gitzzc/GLHW/VacuumGauge/微信图片_20200117162444.jpg

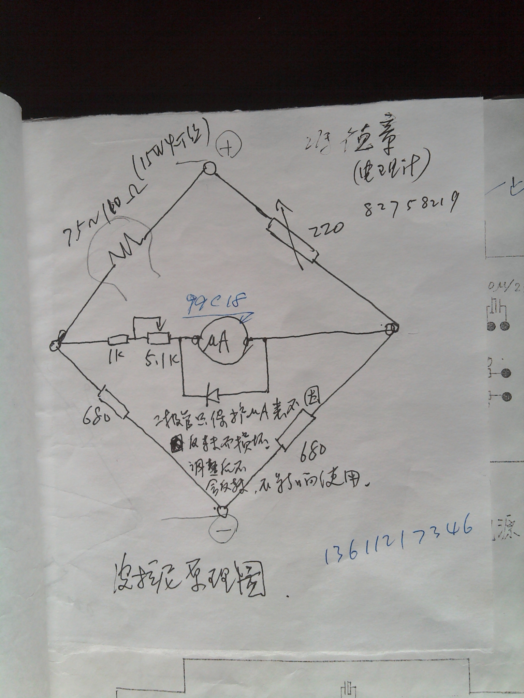
VacuumGauge/微信图片_20200117162444.jpg
