gitzzc/GLHW/AL1000/Ver1.10/更改说明.txt

20200602 
问题：		RS485无法接收数据
原因：		ADUM输入信号需要进行上拉处理，
处理方式：	临时短路二极管，改板时在ADUM输入信号进行上拉。
