gitzzc/GLHW/AL1000/Ver1.10/AL1000装配资料/AL1000-1.xlsx

Comment | Description | Designator | Footprint | LibRef | Quantity
100nF | 贴片电容 | C1, C2, C3, C4, C5, C7, C8, C9, C14, C15, C18, C20, C22, C23, C26, C28, C31, C34, C36_1, C36_2, C36_3, C38_1, C38_2, C38_3, C39_1, C39_2, C39_3, C42_1, C42_2, C42_3, C45_1, C45_2, C45_3, C46_1, C46_2, C46_3, C47_1, C47_2, C47_3, C48_1, C48_2, C48_3, C49_1, C49_2, C49_3, C50_1, C50_2, C50_3, C51_1, C51_2, C51_3, C52_1, C52_2, C52_3, C53_1, C53_2, C53_3, C54_1, C54_2, C54_3, C55_1, C55_2, C55_3, C56_1, C56_2, C56_3, C57, C59, C60, C61, C62, C63, C64, C65, C66, C67, C68, C69, C70, C71, C72, C73, C74, C75, C77, C78, C80, C82, C83, C84, C85, C86, C87, C88, C90, C92, C93, C94, C95, C96, C97, C99, C100, C102, C103, C104, C105 | 0805_C | 0805 100nF(104) 10% 50V | 107
10uF | Capacitor, 贴片电容 | C6, C12, C13, C17, C19, C21, C25, C27, C33, C37_1, C37_2, C37_3, C41_1, C41_2, C41_3, C76, C79, C89, C101 | 0805_C | 0805 10uF (106) 10% 25V, 1206 10uF (106) 10% 50V, CC | 19
100pF/2KV | Capacitor | C10, C81, C91, C98 | 1206_C | Cap | 4
47uF/50V | Electrolytic Capacitor | C11 | CD1/2 | CD1 | 1
10uF/50V | 贴片电容 | C16, C24 | 1206_C | 1206 10uF (106) 10% 50V | 2
10pF | Capacitor | C29, C30 | 0805_C | CAP | 2
10nF | 多层瓷介电容 | C32 | 0805_C | G-CC41-0805-CG-50V-300J | 1
1nF | Capacitor | C35_1, C35_2, C35_3, C40_1, C40_2, C40_3, C43_1, C43_2, C43_3, C44_1, C44_2, C44_3 | 0805_C | CAP | 12
100uF/50V | Polarized Capacitor (Radial) | C58 | CD1.5/3.2 | Cap Pol1 | 1
SS54 |  | D1 | SMA(DO-214AC)_S1 | SMA(DO-214AC) SS54 | 1
1.5SMC33CA |  | D2, D31 | SMC(DO-214AB)_S1 | TVS | 2
SMA6J5CA | 1V5KE6V8CA | D3, D22, D23, D24 | SMA | Bidirectional DIODE TVS, TVS | 4
STM32F107VCT |  | D4 | LQFP-100_14x14x05P | BARRACUDA_256K | 1
1N4148W | Default Diode | D5, D6, D26, D28 | SOD-123 | Diode | 4
M7 |  | D7_1, D7_2, D7_3 | SMA(DO-214AC)_S1 | SMA(DO-214AC) M7 | 3
SMAJ18A | 1V5KE6V8CA | D8_1, D8_2, D8_3, D9_1, D9_2, D9_3, D10_1, D10_2, D10_3, D15, D16, D17, D18, D19, D20, D21 | SMA | Bidirectional DIODE TVS, TVS | 16
红灯 0805 |  | D11_1, D11_2, D11_3, D13_1, D13_2, D13_3, D25, D27 | 0805_LED_S1 | 0805 红灯 | 8
SMF12 | Zener Diode | D12_1, D12_2, D12_3, D14_1, D14_2, D14_3 | SOD-123 | D Zener | 6
GZ2012D101TF |  | L1, L2, L3, L4, L5_1, L5_2, L5_3, L6_1, L6_2, L6_3, L8_1, L8_2, L8_3, L9_1, L9_2, L9_3, L11, L12, L13, L14, L15, L16, L17 | 0805_L | L1 | 23
NT90RN1C |  | LS1, LS2 | NT90HCE12CE | NT90RN1C | 2
Header 9 | Header, 9-Pin | M1, M2, M3, M4, M5, M6 | LK | Header 9 | 6
24V | Header, 2-Pin | P1, P9 | mc1.5/2-st-3.81 | Header 2 | 2
Header 6 | Header, 6-Pin | P2 | TJC3-6A | Header 6 | 1
ESP-07S | Header, 8-Pin, Dual row | P3 | ESP-07S | Header 8X2 | 1
Header 8 | Header, 8-Pin | P4_1, P4_2, P4_3, P8 | MC1.5/8-ST-3.81 | Header 8 | 4
 | Header, 4-Pin, Right Angle | P5 | MSTBV 2.5/4-G-5.08 | Header 4H | 1
Header 5 | Header, 5-Pin | P6, P7 | MC1.5/5-ST-3.81 | Header 5 | 2
Header 15X2 | Header, 15-Pin, Dual row | P10 | HDR2X15 | Header 15X2 | 1
HY911105AE |  | P11 | HANRUN-A8 | J0011D21B | 1
BAT | Header, 2-Pin | P12 | TJC3-2A | Header 2 | 1
DB9/F |  | P13 | DB9P/F | DB9 | 1
MMBT5401 2L |  | Q1_1, Q1_2, Q1_3, Q2_1, Q2_2, Q2_3, Q8_1, Q8_2, Q8_3, Q9, Q11 | SOT-23(SOT-23-3) | SOT-23 MMBT5401 2L | 11
2N7002 | MOS(场效应管) | Q3_1, Q3_2, Q3_3, Q5_1, Q5_2, Q5_3 | SOT-23(SOT-23-3) | 2N7002 7002 | 6
IRLR024N | HEXFET Power MOSFET | Q4_1, Q4_2, Q4_3 | TO-252AA_N | IRLR024N | 3
IRFR5305 | HEXFET Power MOSFET | Q7_1, Q7_2, Q7_3 | TO-252AA_N | IRFR5305 | 3
2K2 | Resistor | R1, R2, R17, R18, R19, R20, R21, R87 | 0805_R | Res1 | 8
1K5 | Resistor | R3, R4 | 0805_R | Res1 | 2
49.9 | Resistor | R5, R6, R7, R8 | 0805_R | Res1 | 4
220 | Resistor | R9, R10 | 0805_R | Res1 | 2
33 | Resistor | R11, R12, R13, R14, R15, R16, R22, R90, R92, R96, R97, R101, R102 | 0805_R | Res1 | 13
4.87K | Resistor | R23 | 0805_R | Res1 | 1
1M | Resistor | R24, R93, R98, R103 | 1206_R | Res1 | 4
1K | Resistor, 贴片电阻 | R25, R31, R45_1, R45_2, R45_3, R50_1, R50_2, R50_3, R52_1, R52_2, R52_3, R55, R56_1, R56_2, R56_3, R105 | 0805_R | 0805 100KΩ (1003) 1%, res1, RMK2012KBxxx（10～1M）F | 16
100K | Resistor, 贴片电阻 | R26, R27, R35_1, R35_2, R35_3, R40_1, R40_2, R40_3, R46_1, R46_2, R46_3, R47_1, R47_2, R47_3, R54_1, R54_2, R54_3, R57_1, R57_2, R57_3, R58_1, R58_2, R58_3, R61_1, R61_2, R61_3 | 0805_R | 0805 100KΩ (1003) 1%, Res1, Res2 | 26
10K | Resistor, 贴片电阻 | R28, R30, R32, R38_1, R38_2, R38_3, R43_1, R43_2, R43_3, R64_1, R64_2, R64_3, R65_1, R65_2, R65_3, R70, R71, R72, R73, R86, R107 | 0805_R | Res1, Res2, RMK2012KBxxx（10～1M）F | 21
NI | 贴片电阻 | R29 | 0805_R | RMK2012KBxxx（10～1M）F | 1
330 | Resistor, 贴片电阻 | R33_1, R33_2, R33_3, R34_1, R34_2, R34_3, R39_1, R39_2, R39_3, R44_1, R44_2, R44_3, R67_1, R67_2, R67_3 | 0805_R | 0805 100Ω (1000) 1%, Res2 | 15
200K | Resistor | R36_1, R36_2, R36_3, R41_1, R41_2, R41_3 | 0805_R | Res2 | 6
100 | Resistor, 贴片电阻 | R37_1, R37_2, R37_3, R42_1, R42_2, R42_3, R49_1, R49_2, R49_3, R88, R89, R91, R94, R95, R99, R100 | 0805_R | 0805 100KΩ (1003) 1%, Res1, Res2 | 16
5.1KΩ | 贴片电阻 | R48_1, R48_2, R48_3, R59_1, R59_2, R59_3 | 0805_R | 0805 5.1KΩ (5101) 1% | 6
22K | 贴片电阻 | R51_1, R51_2, R51_3 | R0805 | RMK2012KBxxx（10～1M）F | 3
10KΩ | 贴片电阻 | R53_1, R53_2, R53_3, R60_1, R60_2, R60_3 | 0805_R | 0805 10KΩ (1002) 1% | 6
33R | Resistor | R62_1, R62_2, R62_3 | R2512 | Res2 | 3
0.33 | Resistor | R63_1, R63_2, R63_3, R82, R83, R84, R85 | R2512 | Res1, Res2 | 7
22K | 贴片电阻 | R66_1, R66_2, R66_3 | 0805_R | RMK2012KBxxx（10～1M）F | 3
510 | Resistor | R68, R69 | 0805_R | Res1 | 2
20K | Resistor | R104, R108 | 0805_R | Res1 | 2
120 | Resistor | R106 | 0805_R | Res1 | 1
ACM9070-701-2PL-TL01 | TDP ACP3225 Common Mode Filters | T1 | ACM1211 | ACP3225 | 1
DP83848CVVX | 接口芯片 | U1 | LQFP-48_7x7x05P | DP83848CVVX_[C16688] | 1
VRB2405YMD-6WR3 |  | U2 | DC/DC-1X1 | 48S5 | 1
LD1117AG-33 | 3-Terminal Adjustable Positive Voltage Regulator | U3 | SOT-223 | LM1117 | 1
HT7550-1 | 低压差线性稳压(LDO) | U4 | SOT-89(SOT-89-3) | SOT-89 HT7550-1 | 1
LM4040AIM3-2.5 | Precision Micropower Shunt Voltage Reference, 3-pin SOT-23 | U5, U12_1, U12_2, U12_3 | MF03A_N | LM4040AIM3-2.5 | 4
FM25W256 |  | U6 | SO8 | SPI_FLASH | 1
SG-310SCF 25MHZ 3.3V |  | U7 | SMD-3225_4P | SM7745HEV-50.0M | 1
HCNR201 |  | U8_1, U8_2, U8_3, U11_1, U11_2, U11_3 | SMD-8_9.0mm | HCNR201 | 6
LM2904-SR | Dual Low-Power Operational Amplifier | U9_1, U9_2, U9_3, U10_1, U10_2, U10_3, U14_1, U14_2, U14_3 | SOIC-8_150mil | LM2904D | 9
ADUM1200AR | Dual Channel Digital Isolator, 2.5 KV rms Insulation Rating, 1 Mbps Data Rate, 150 ns Delay, Industrial, 8-pin SOIC (R-8), Tube | U13_1, U13_2, U13_3, U20, U22, U24, U26 | ADI-R-8_N | ADUM1200AR | 7
EL817S1(C)(TU)-F |  | U15_1, U15_2, U15_3, U16, U17, U27, U38 | LC-SMD-4 | TLP521 | 7
A4950 |  | U19, U21, U23, U25 | LC-SOIC-8_EP_150mil | A4950 | 4
MAX232ESE | RS232 | U28, U31, U34 | SOIC-16_150mil | MAX232ESE_[C26860] | 3
B0505S-W2R2 | MORNSUN Fixed input,Isolated,Unregulated Series DC/DC | U29, U32, U35 | MORNSUN-BM | MORNSUN-BM | 3
ADUM1201ARZ-RL7 |  | U30, U33, U36 | SOIC-8_150mil | ADUM1201ARZ-RL7_[C9669] | 3
SP485EEN-L/TR | RS-485/RS-422 | U37 | SOIC-8_150mil | SP485EEN-L/TR_[C6855] | 1
32.768KHz ±20ppm 12.5pF | 贴片晶振 | Y1 | SMD-3215_2P FC - 135 | SMD-3215_2P 32.768KHz 20ppm 12.5pF | 1
