gitzzc/GLHW/(list of files, cad)

Other CAD files:
AL1000/Ver1.10/AL1000.DWG
