gitzzc/GLHW/AL1000/Ver1.10/AL1000.pdf

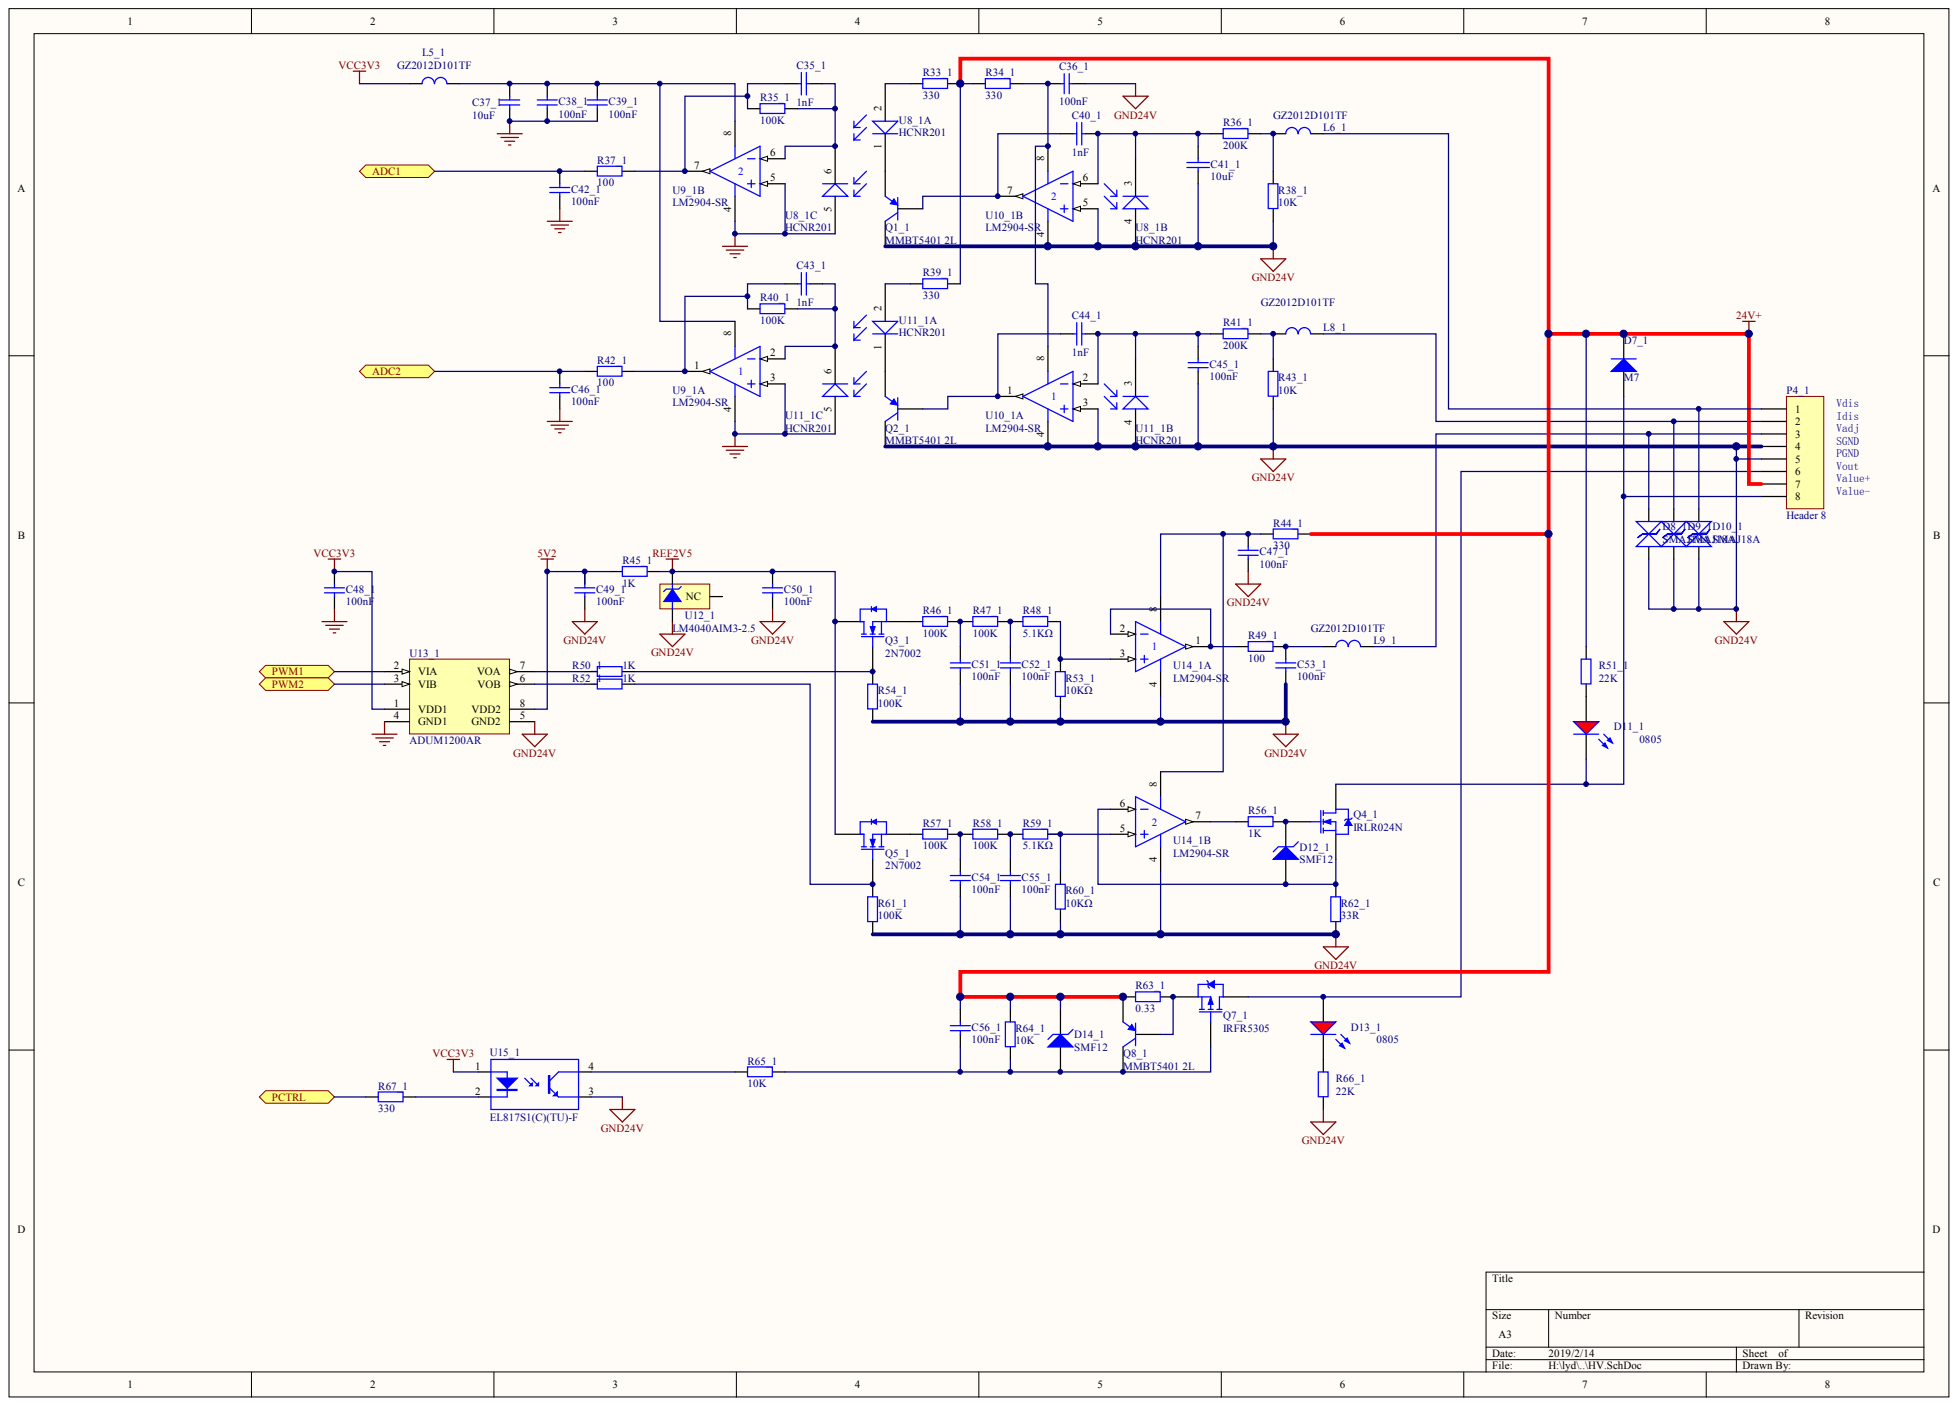
[picture p2: page 1]

GND24V

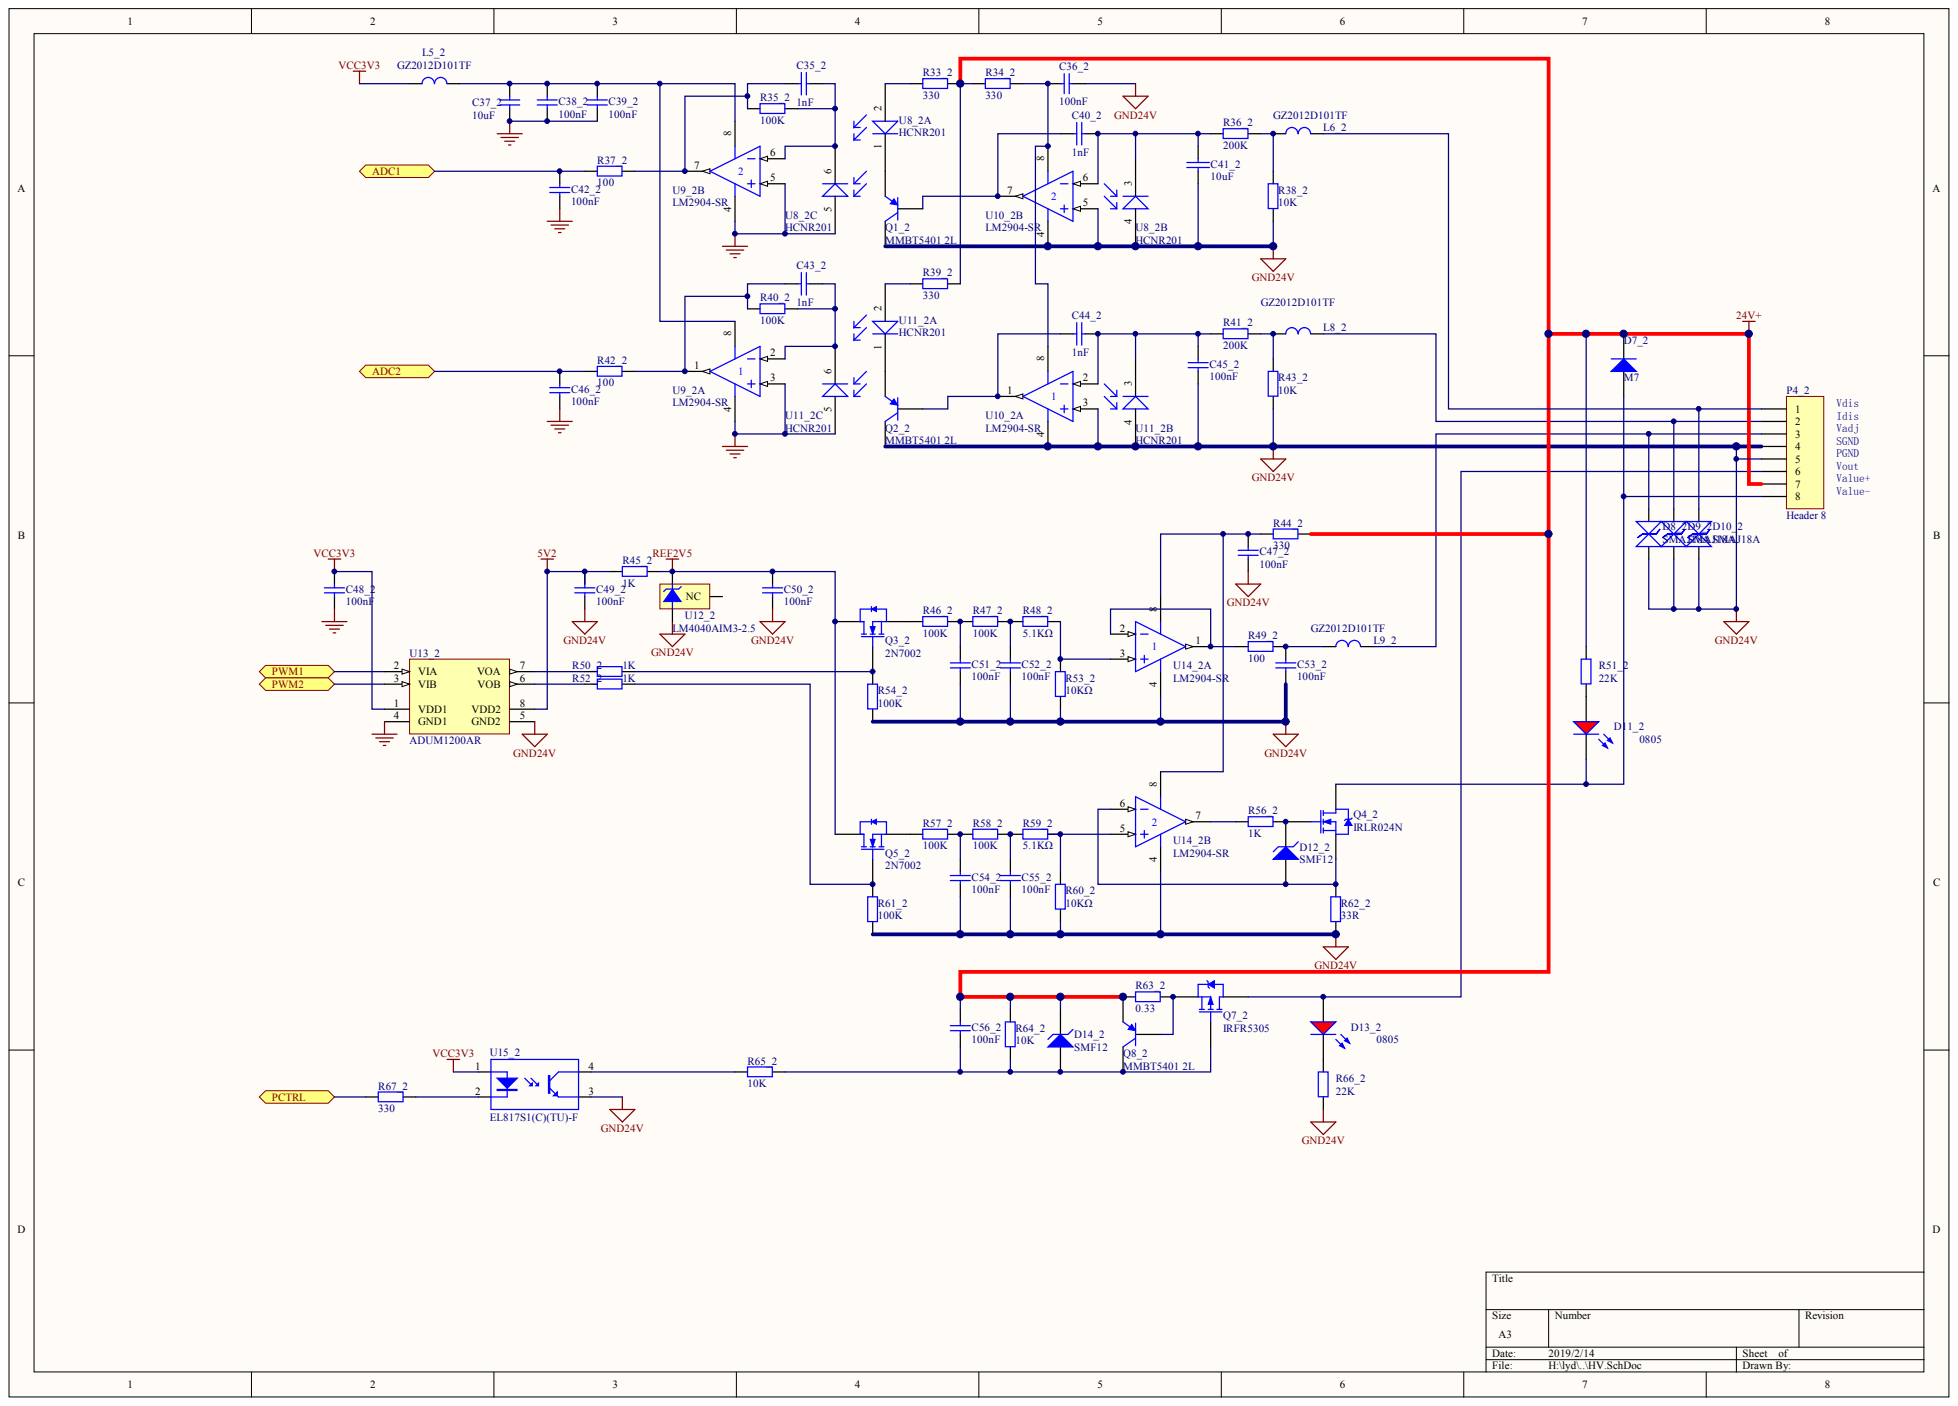
[picture p3: page 2]

GND24V

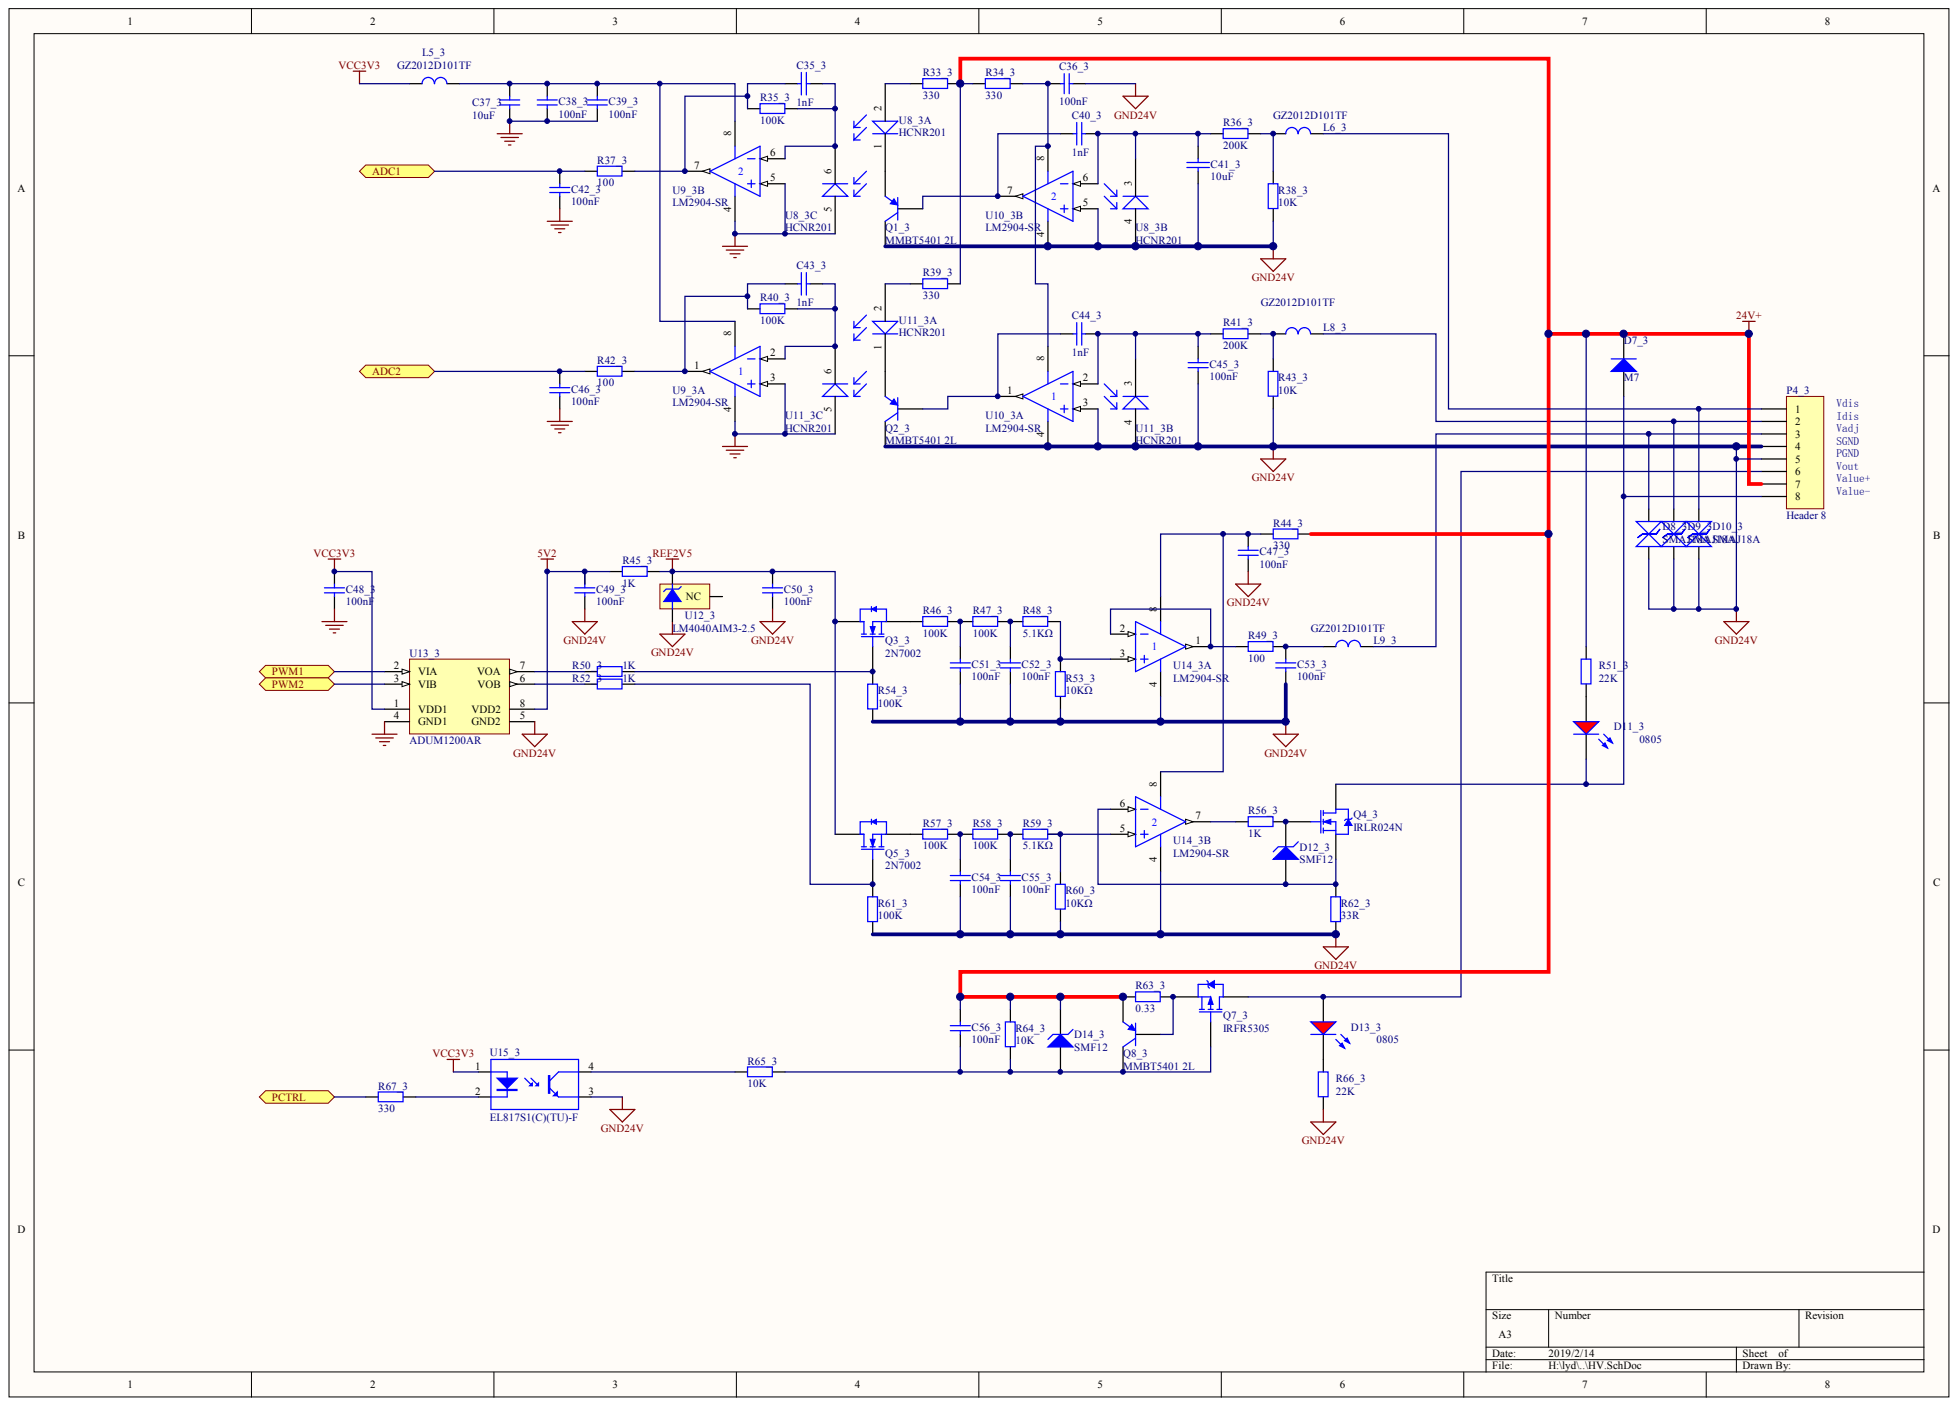
[picture p4: page 3]

GND24V

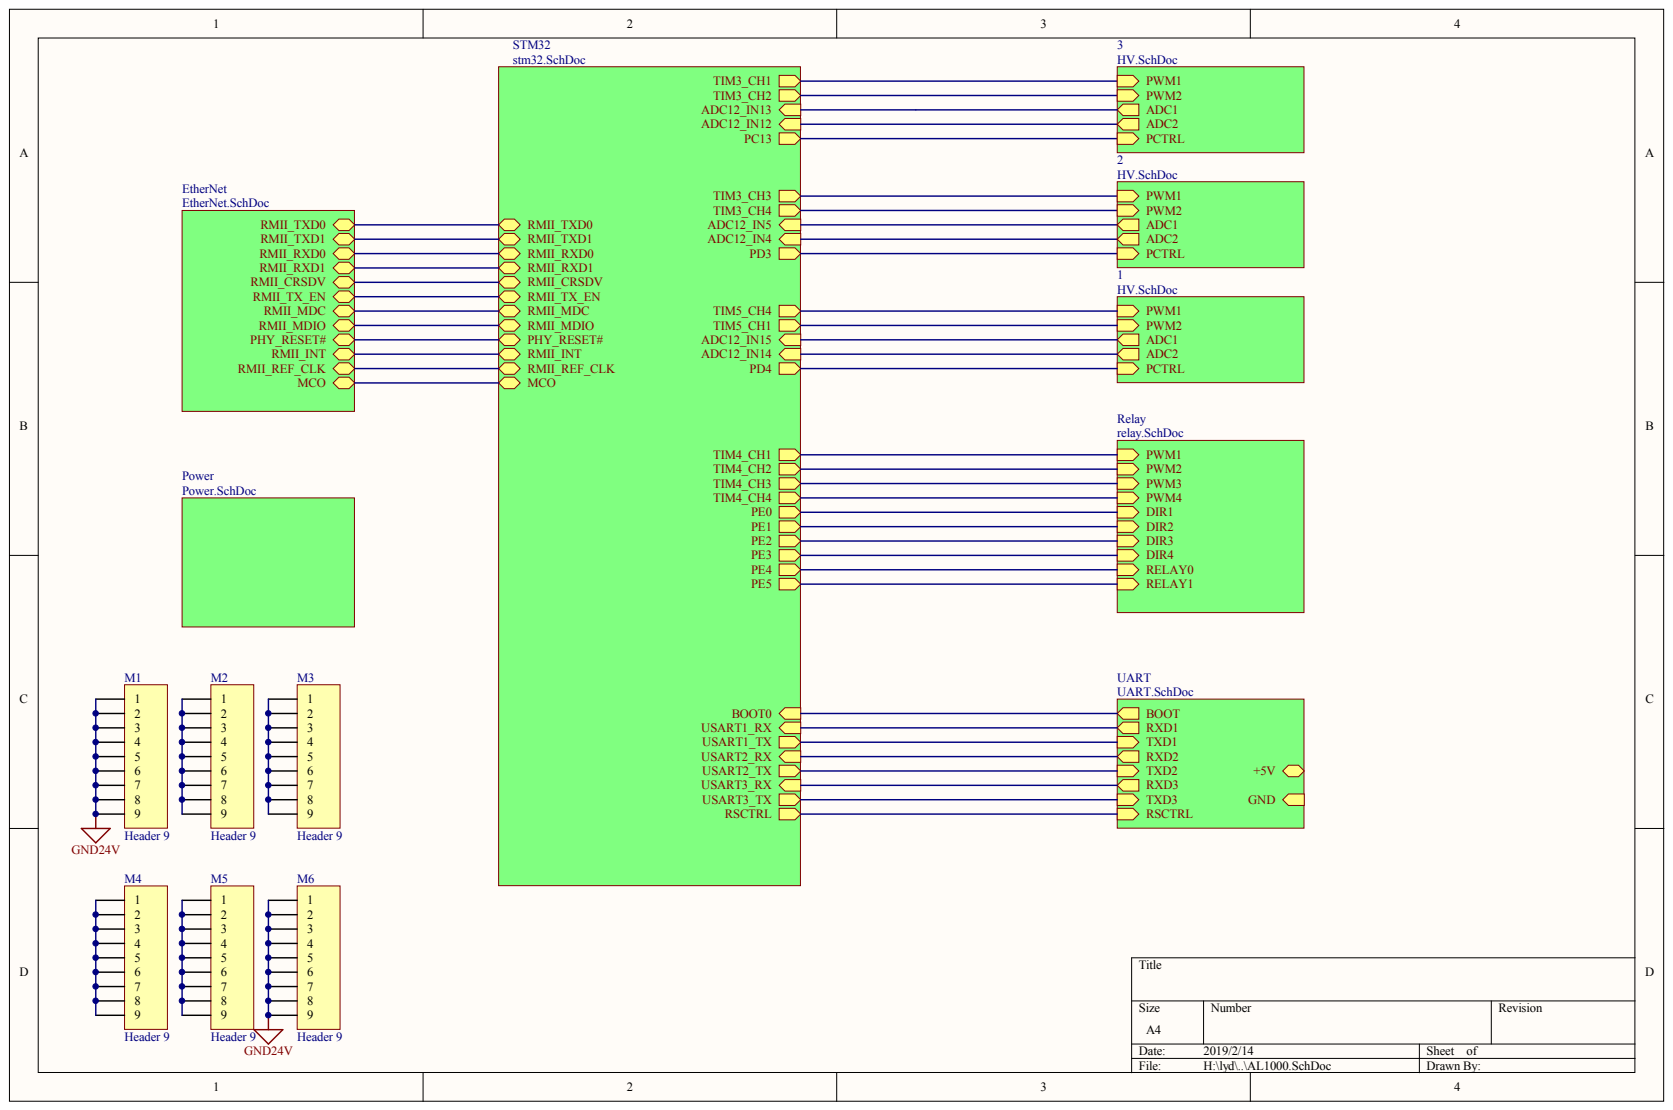
[picture p5: page 4]

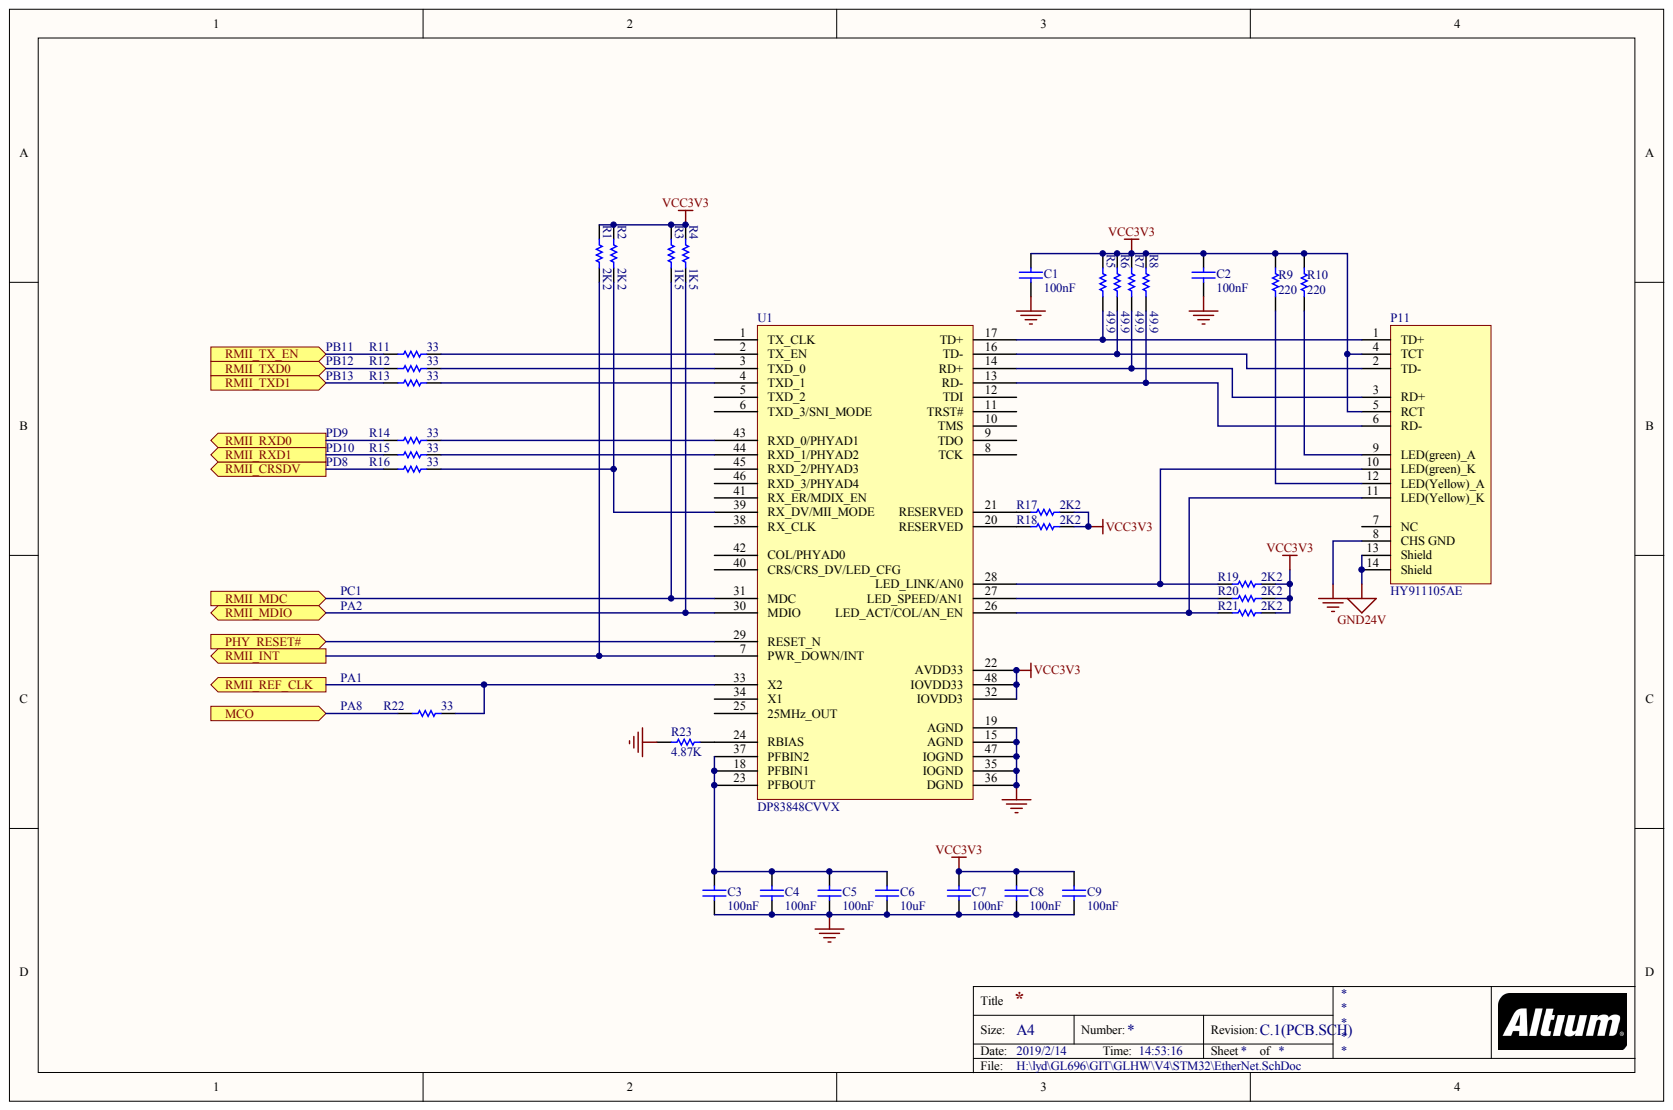
[picture p6: page 5]

TX_EN 2 | | TCT 4
TXD_0 3 | TD- 2
TXD_1 4 | | RD+ 3
TXD_2 5
TXD_3/SNI_MODE 6 | RCT 5

RXD_1/PHYAD2 44

LED(green)_A 9

COL/PHYAD0 42 | | CHS GND 8

Shield 13

Title * | * * * * *

Size: A4 | Number: * | Revision: C.1(PCB.SCH)
Date: 2019/2/14 Time: 14:53:16 | | Sheet * of *

H:\lyd\GL696\GIT\GLHW\V4\STM32\EtherNet.SchDoc

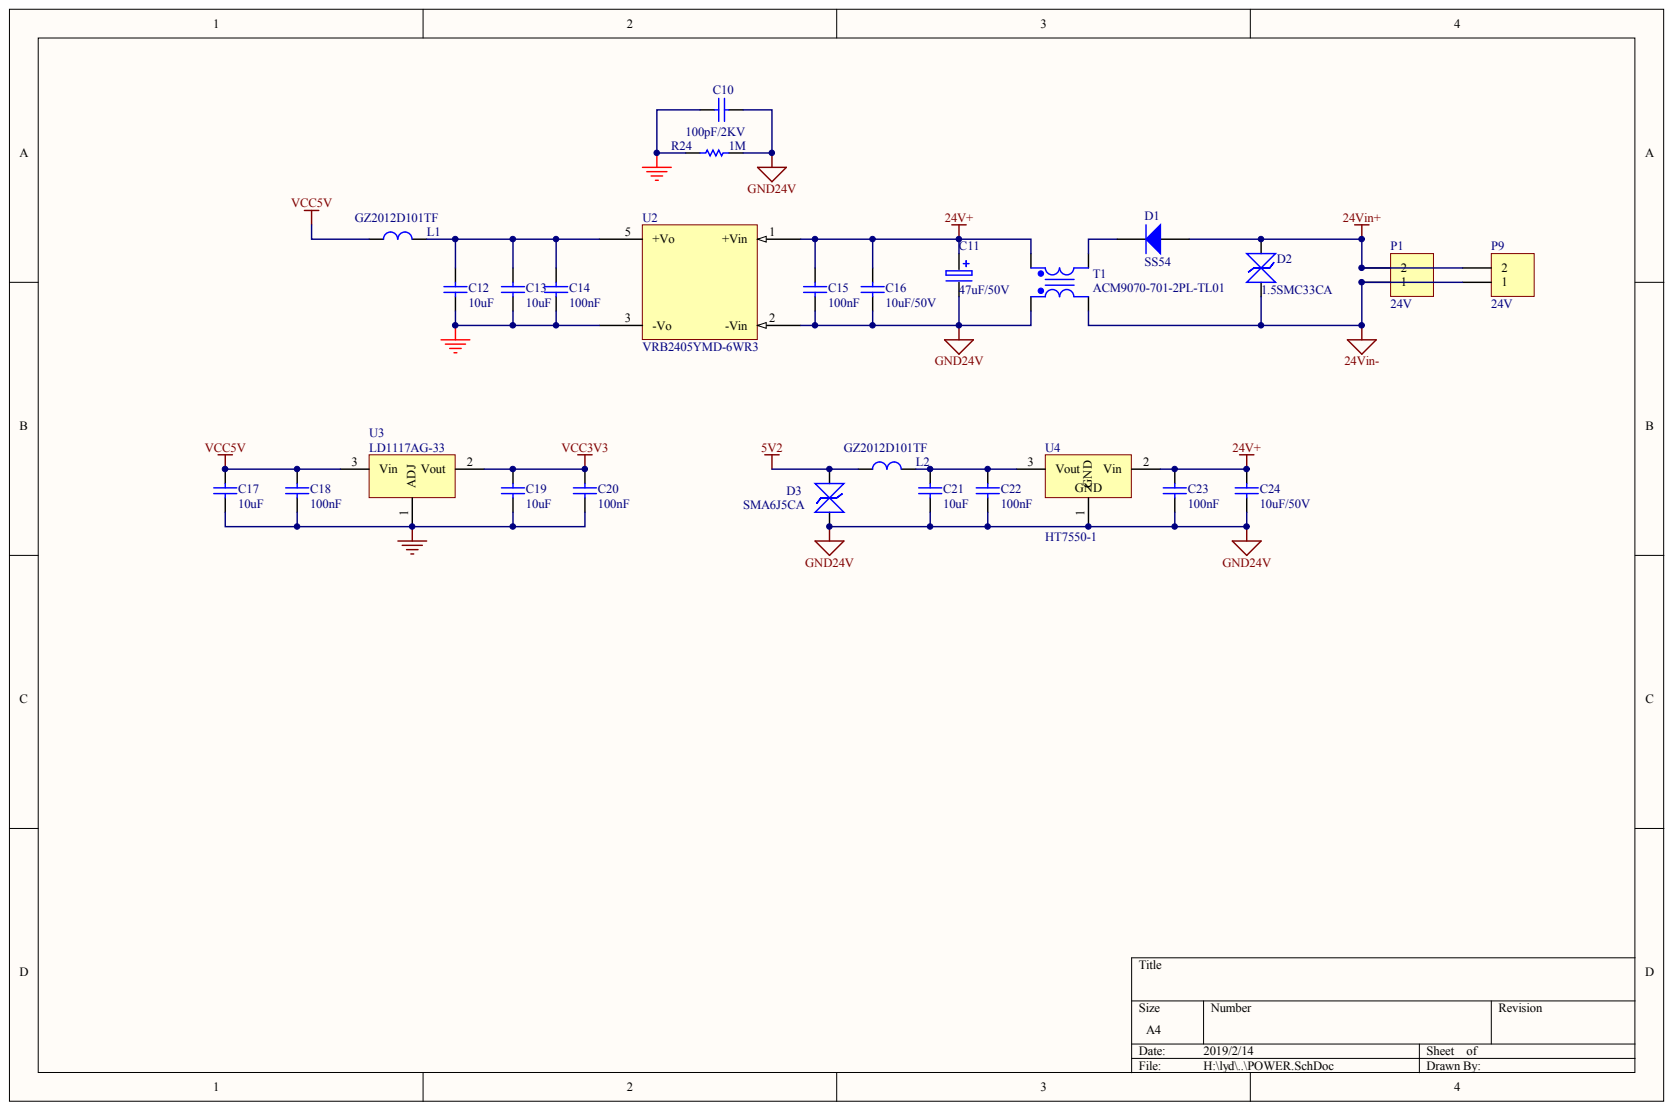
[picture p7: page 6]

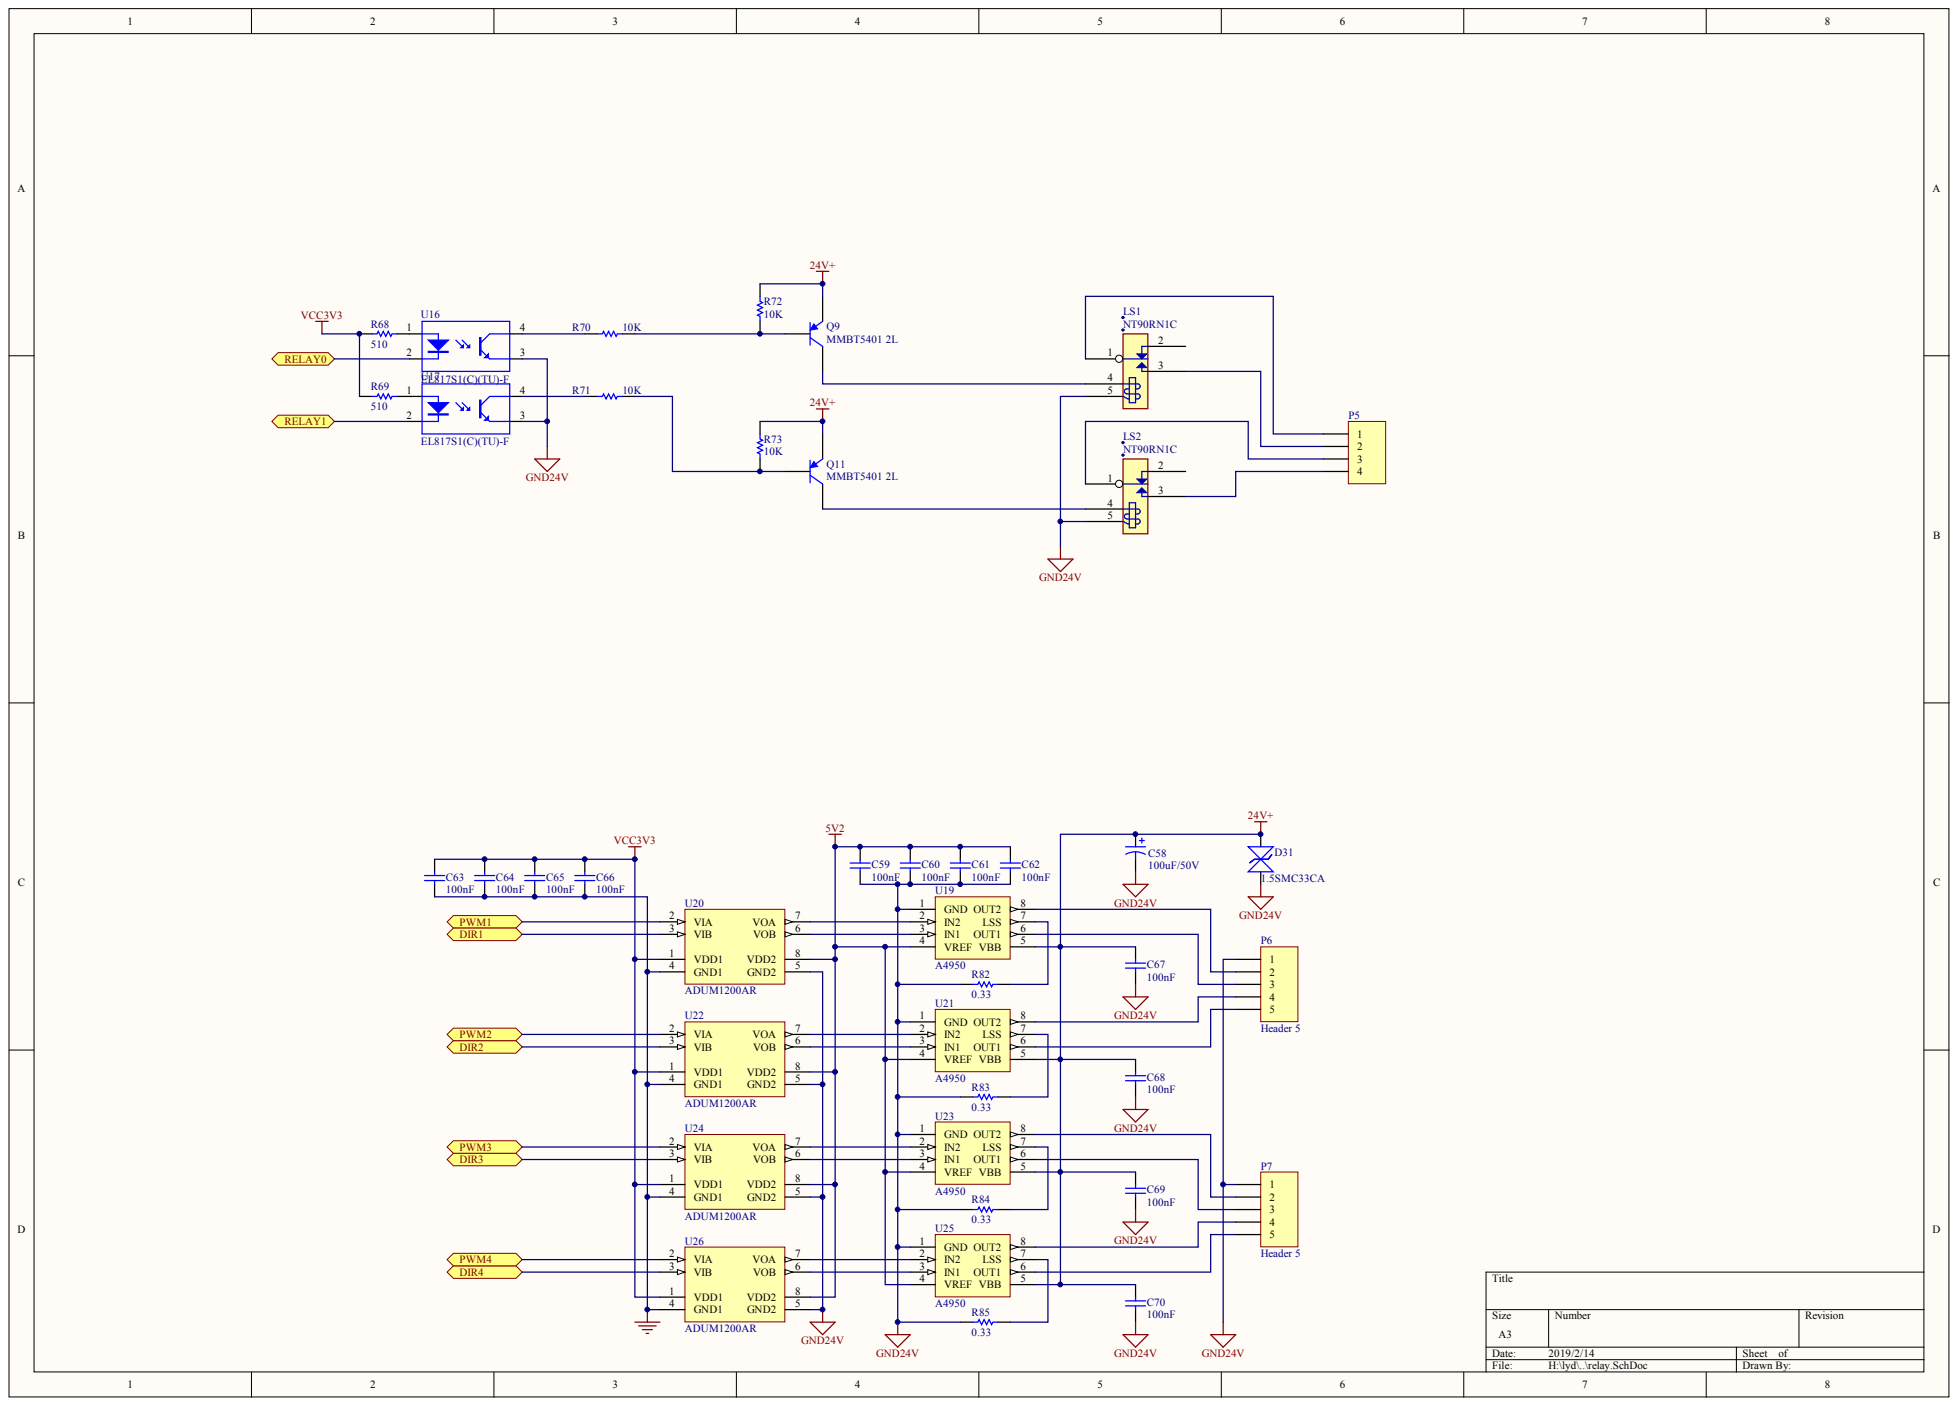
[picture p8: page 7]

GND 1

VIB 3
VDD1 1 | VREF 4

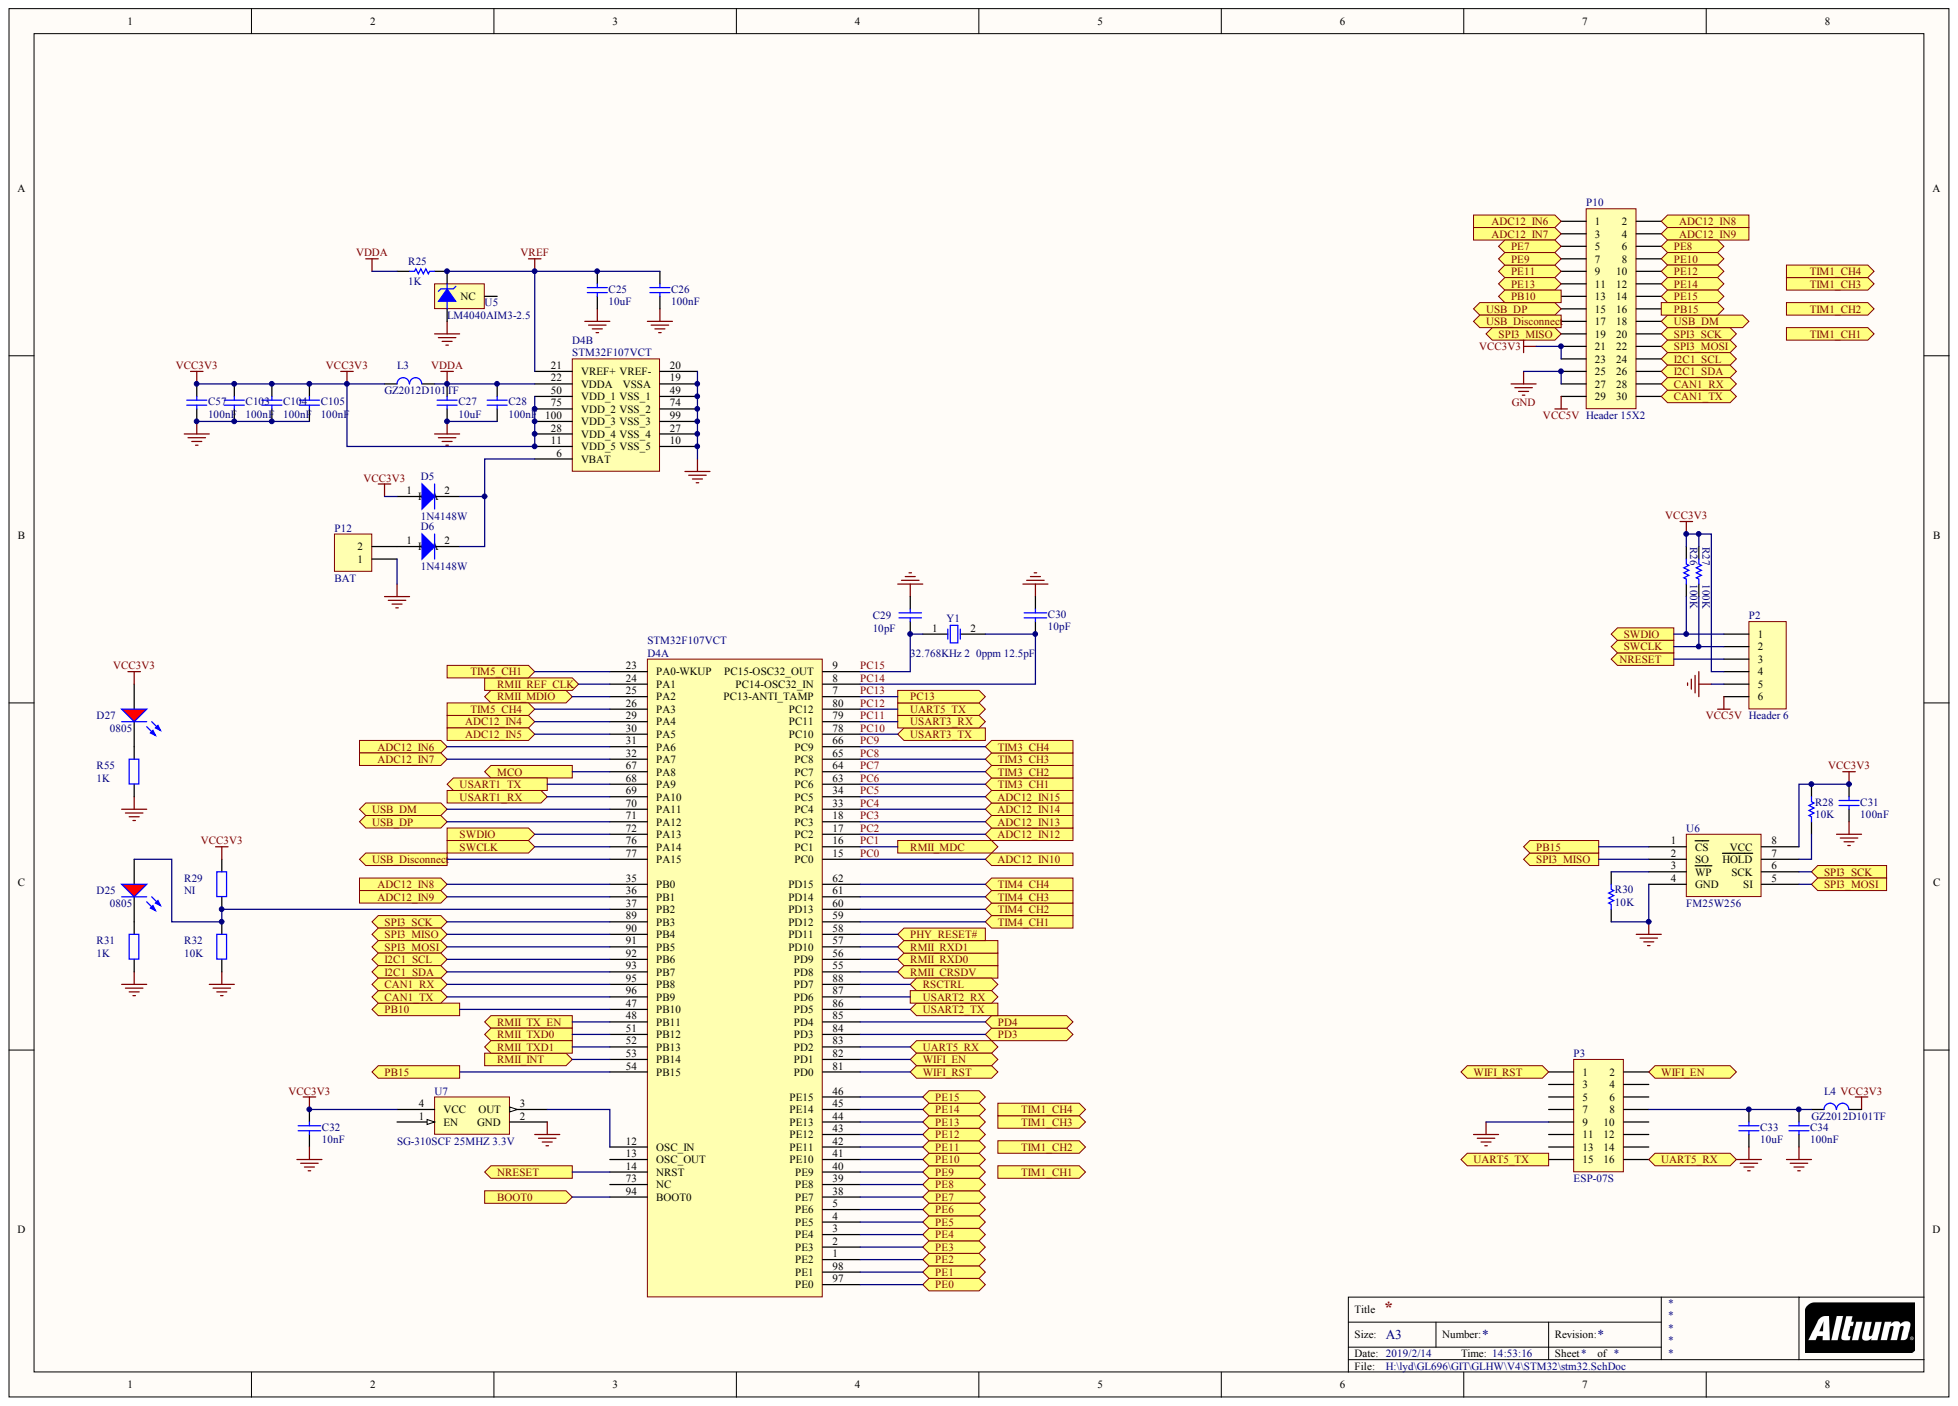
[picture p9: page 8]

2 8 | 2
1 1 | 1

A | mber: * | Revisio n : *

9/2/1 Time: 4:5 3:1 | | S heet * o f *

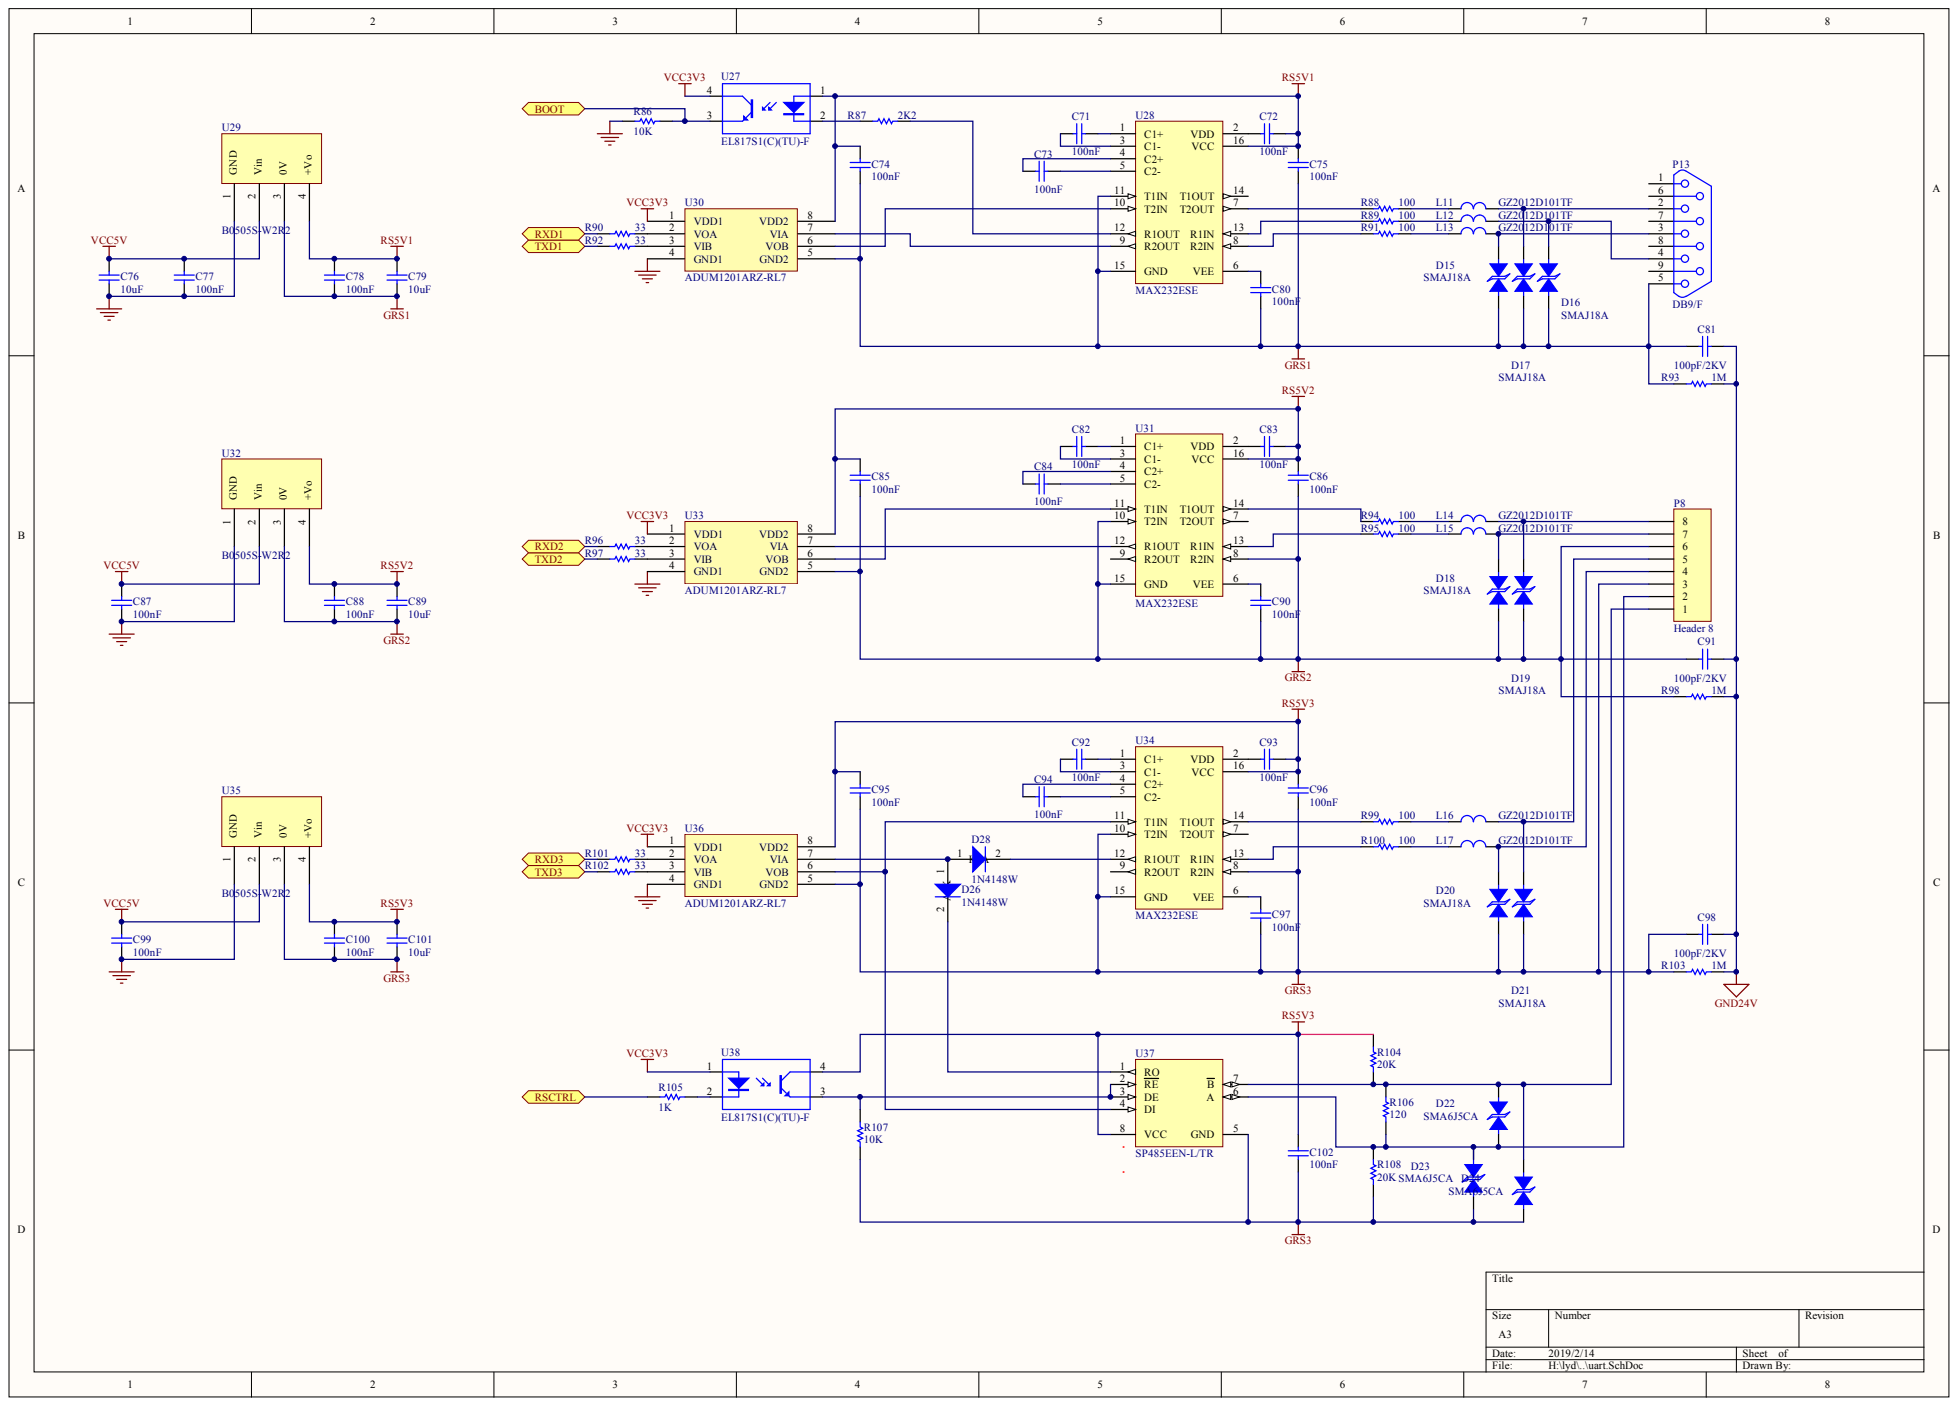
[picture p10: page 9]

C7 4 | C7 3 1 0 0 n F | 4 | C1 -VCC C2 + C2 -

3 D2 1 SMAJ1 8 A RS

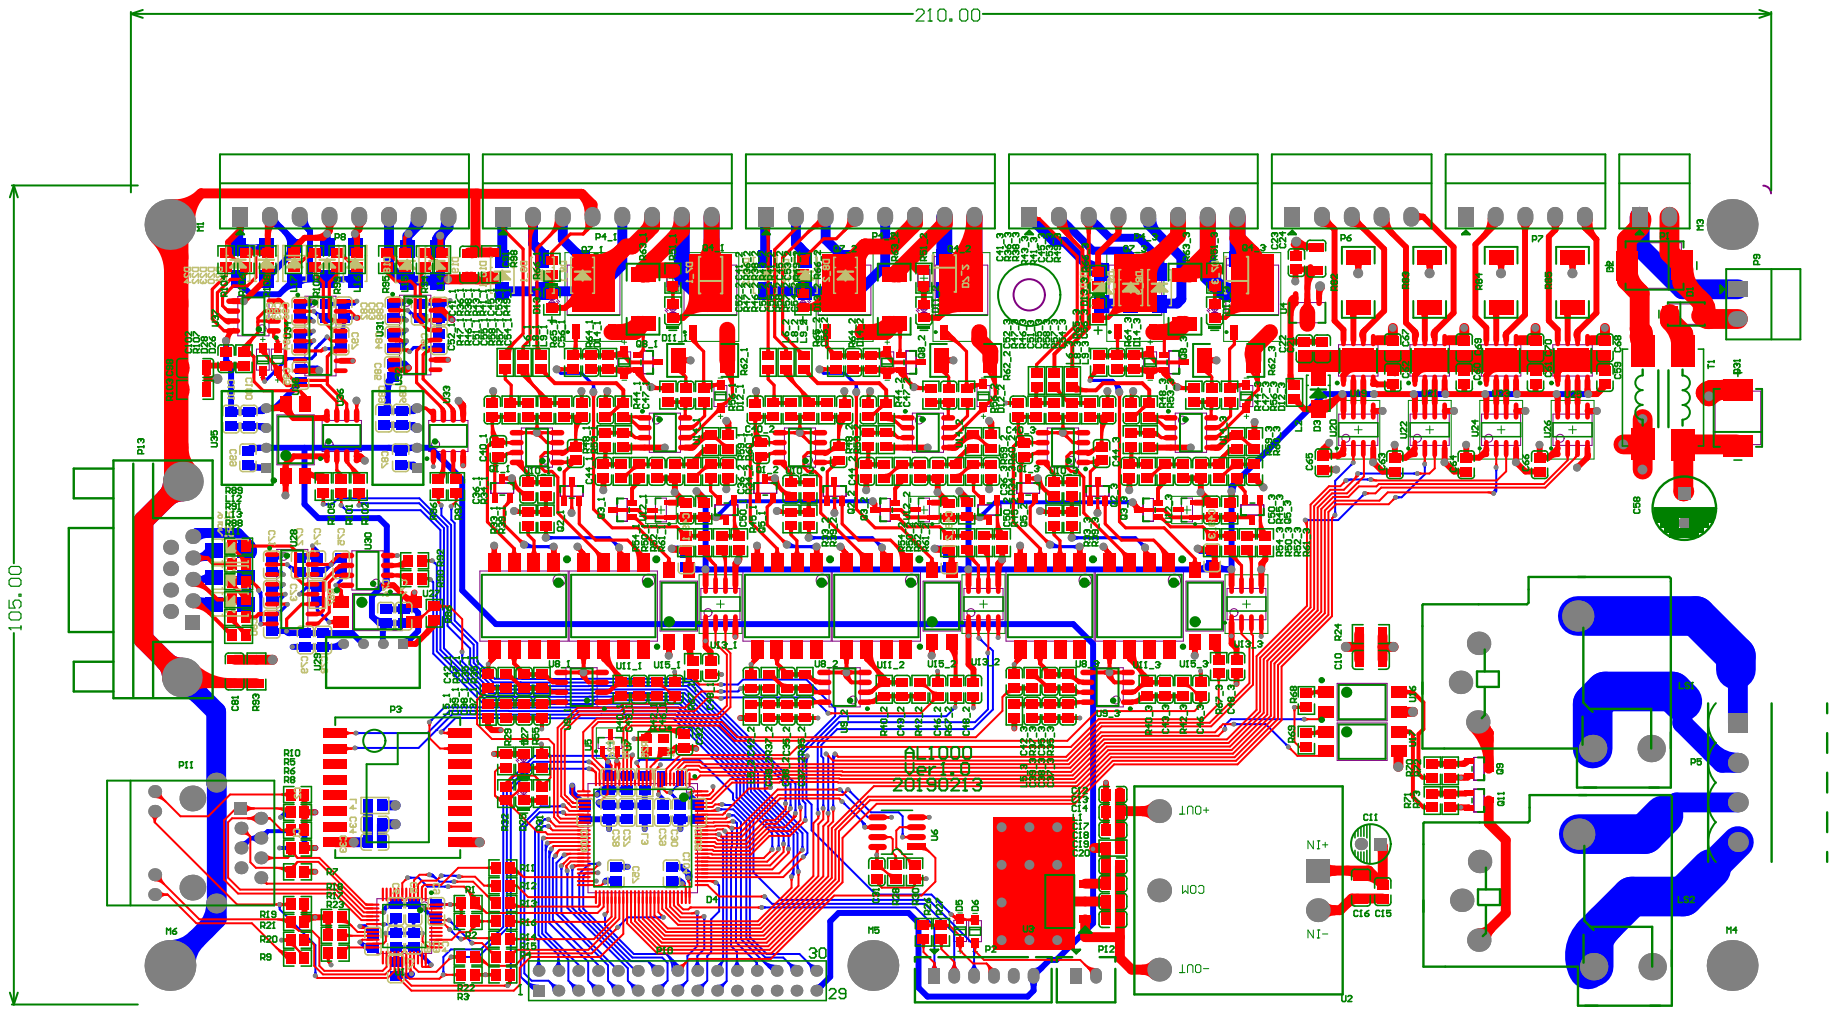
[picture p11: page 10]
