gitzzc/GLHW/AL1000/Ver1.10/AL1000装配图.pdf

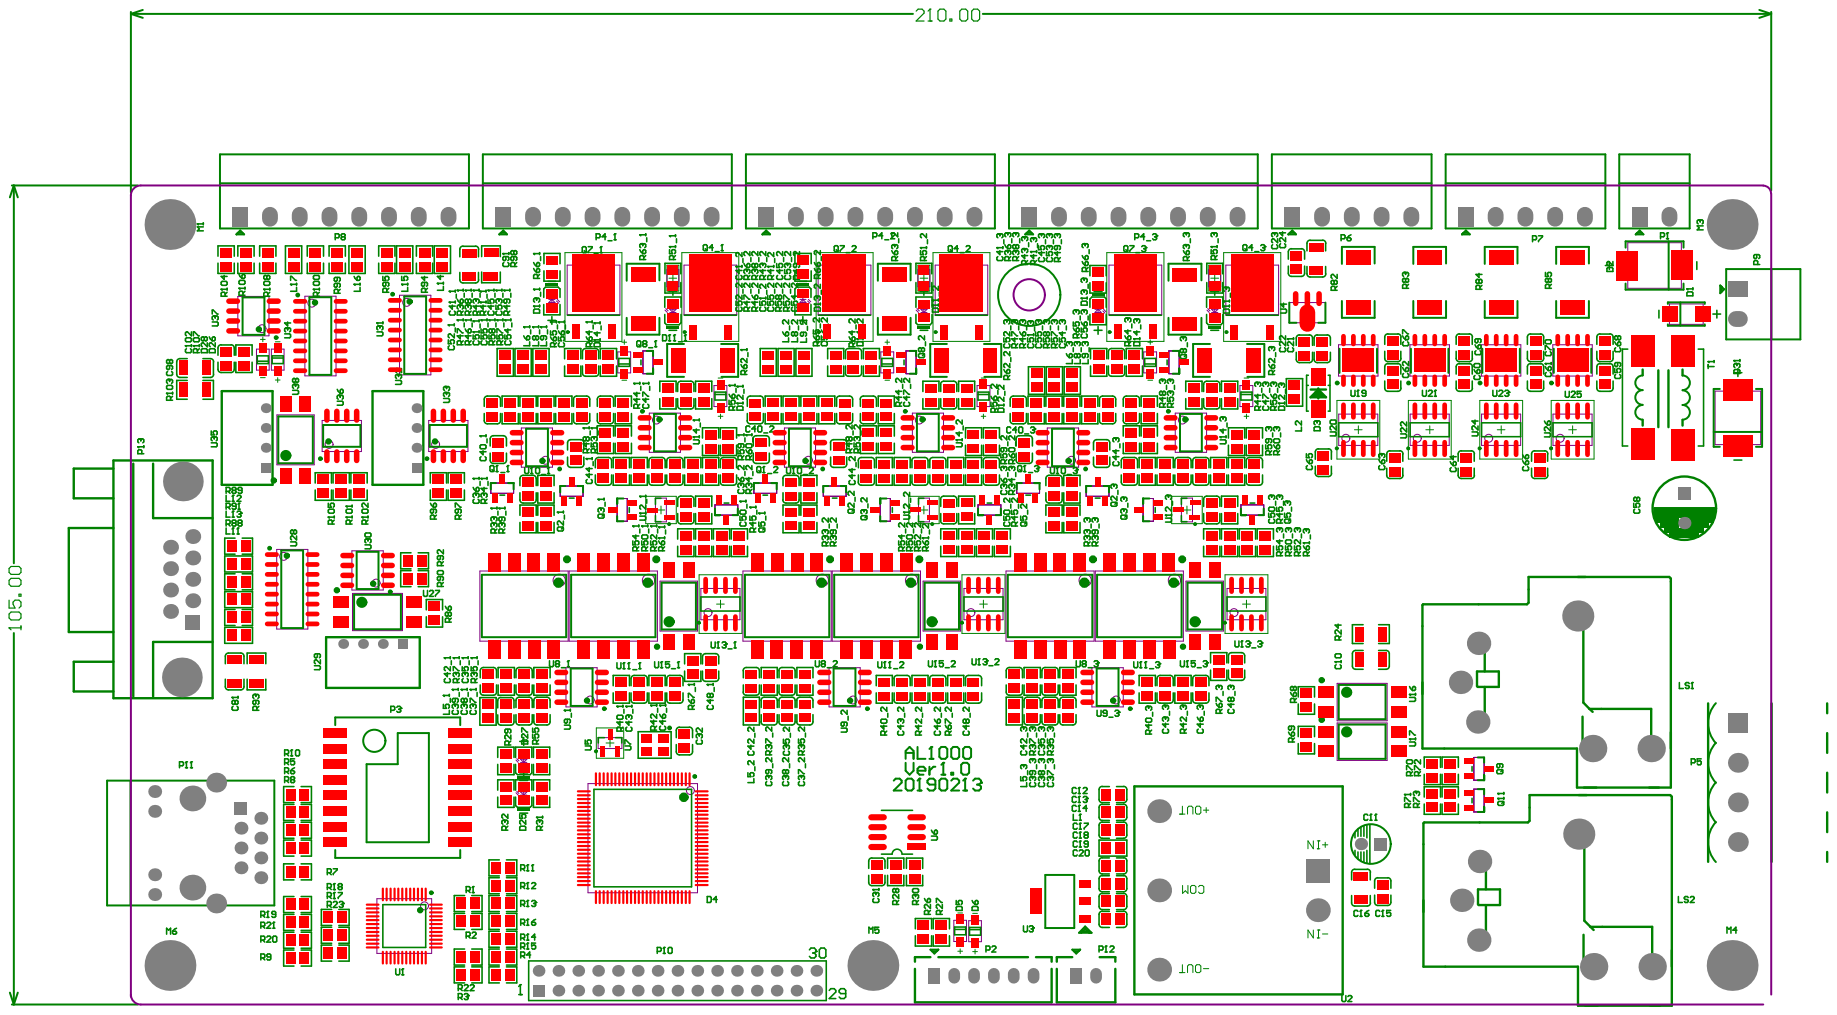
[picture p12: page 1]

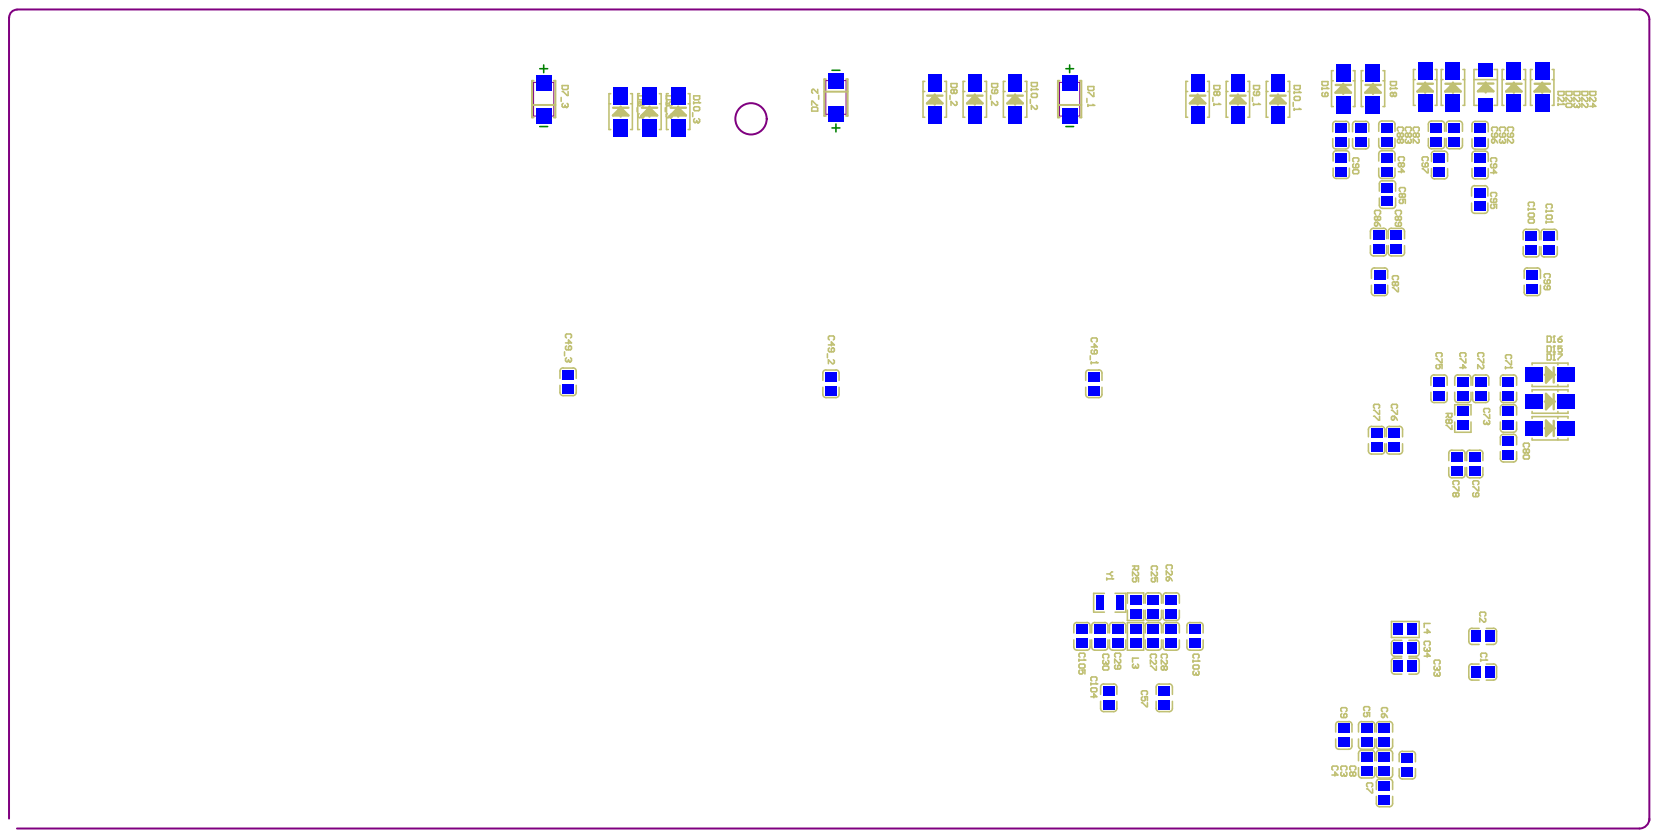
[picture p13: page 2]
