gitzzc/GLHW/AL1000/Ver1.10/AL1000装配图2.pdf

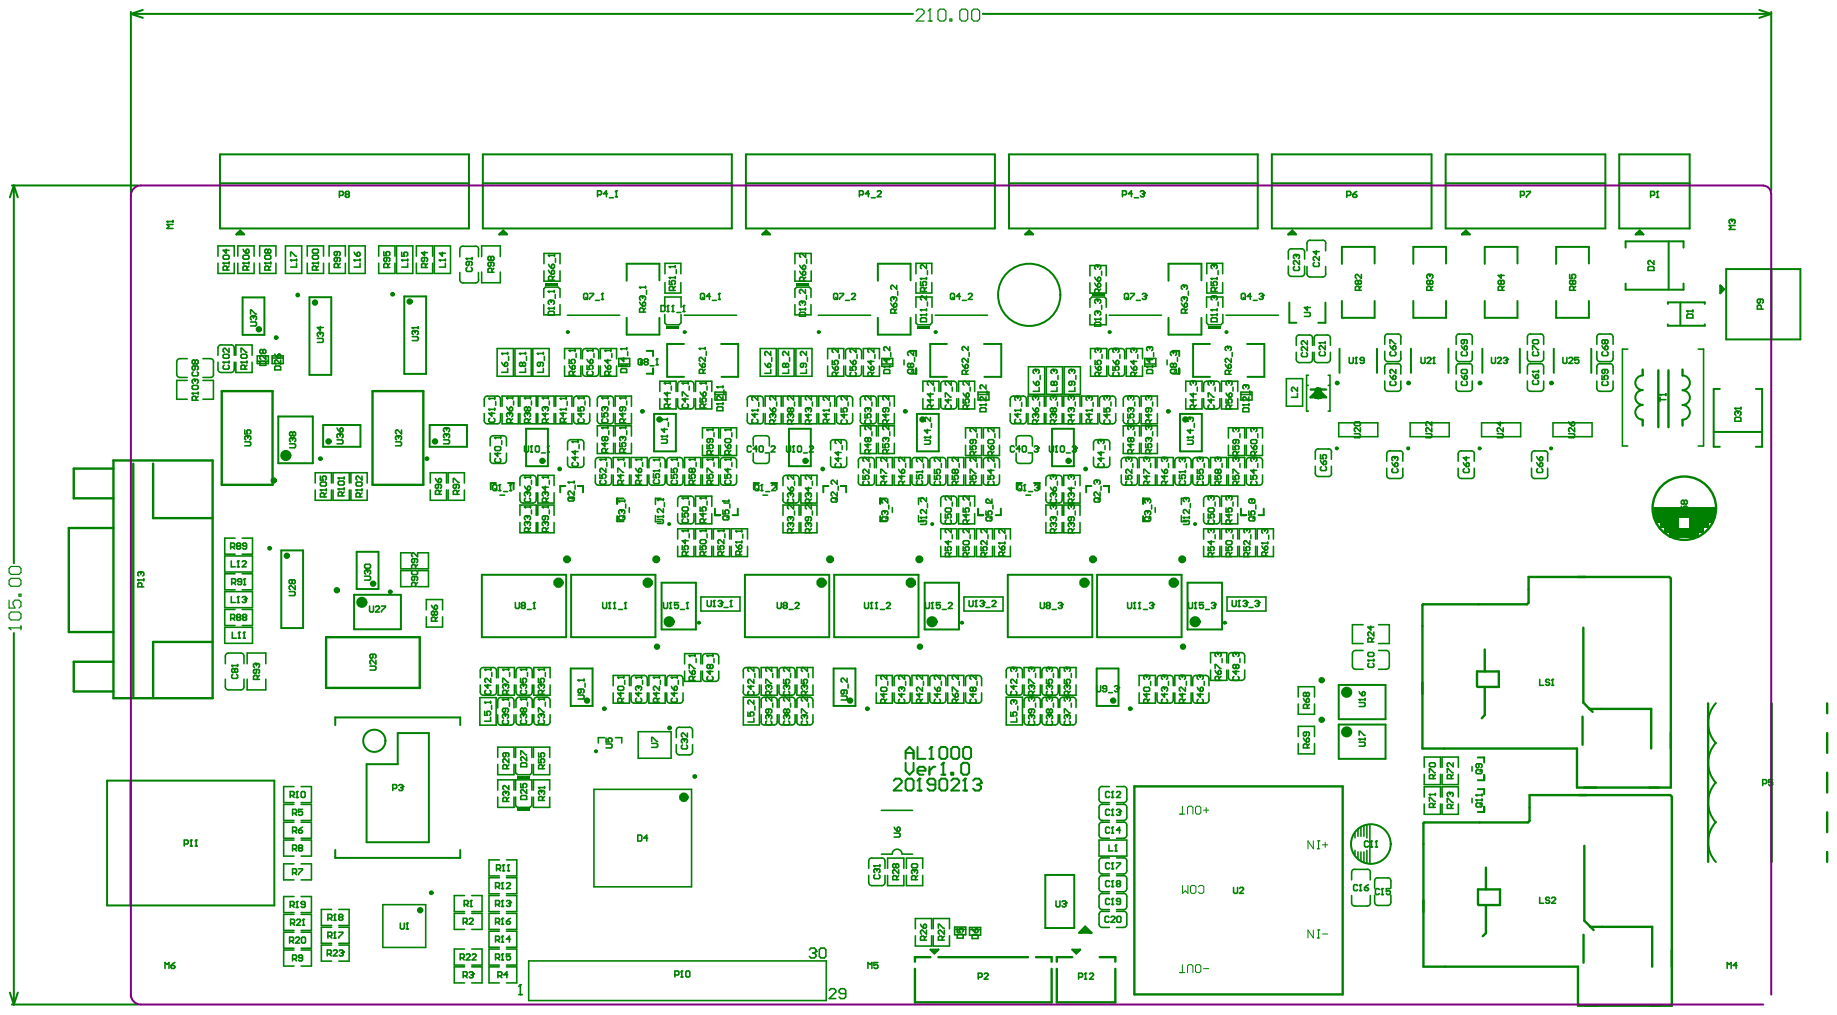
[picture p14: page 1]

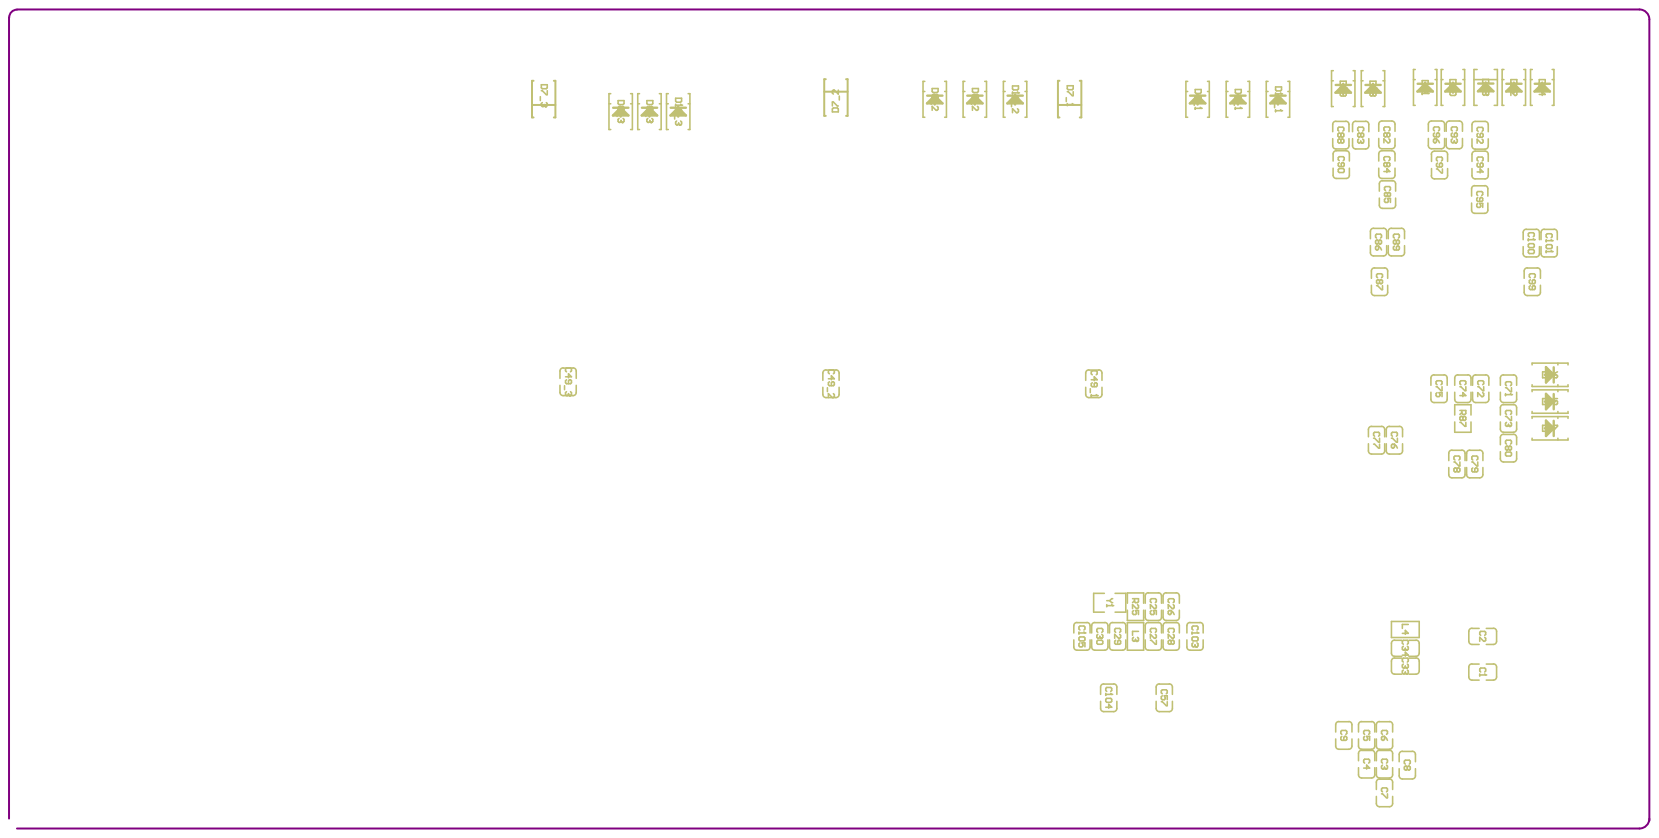
[picture p15: page 2]
