gitzzc/GLHW/AL1000/Ver1.10/接线、装配/Schematic_AL1000_系统接线图.SchDoc_20200329145429.pdf

P812345678

P8-7

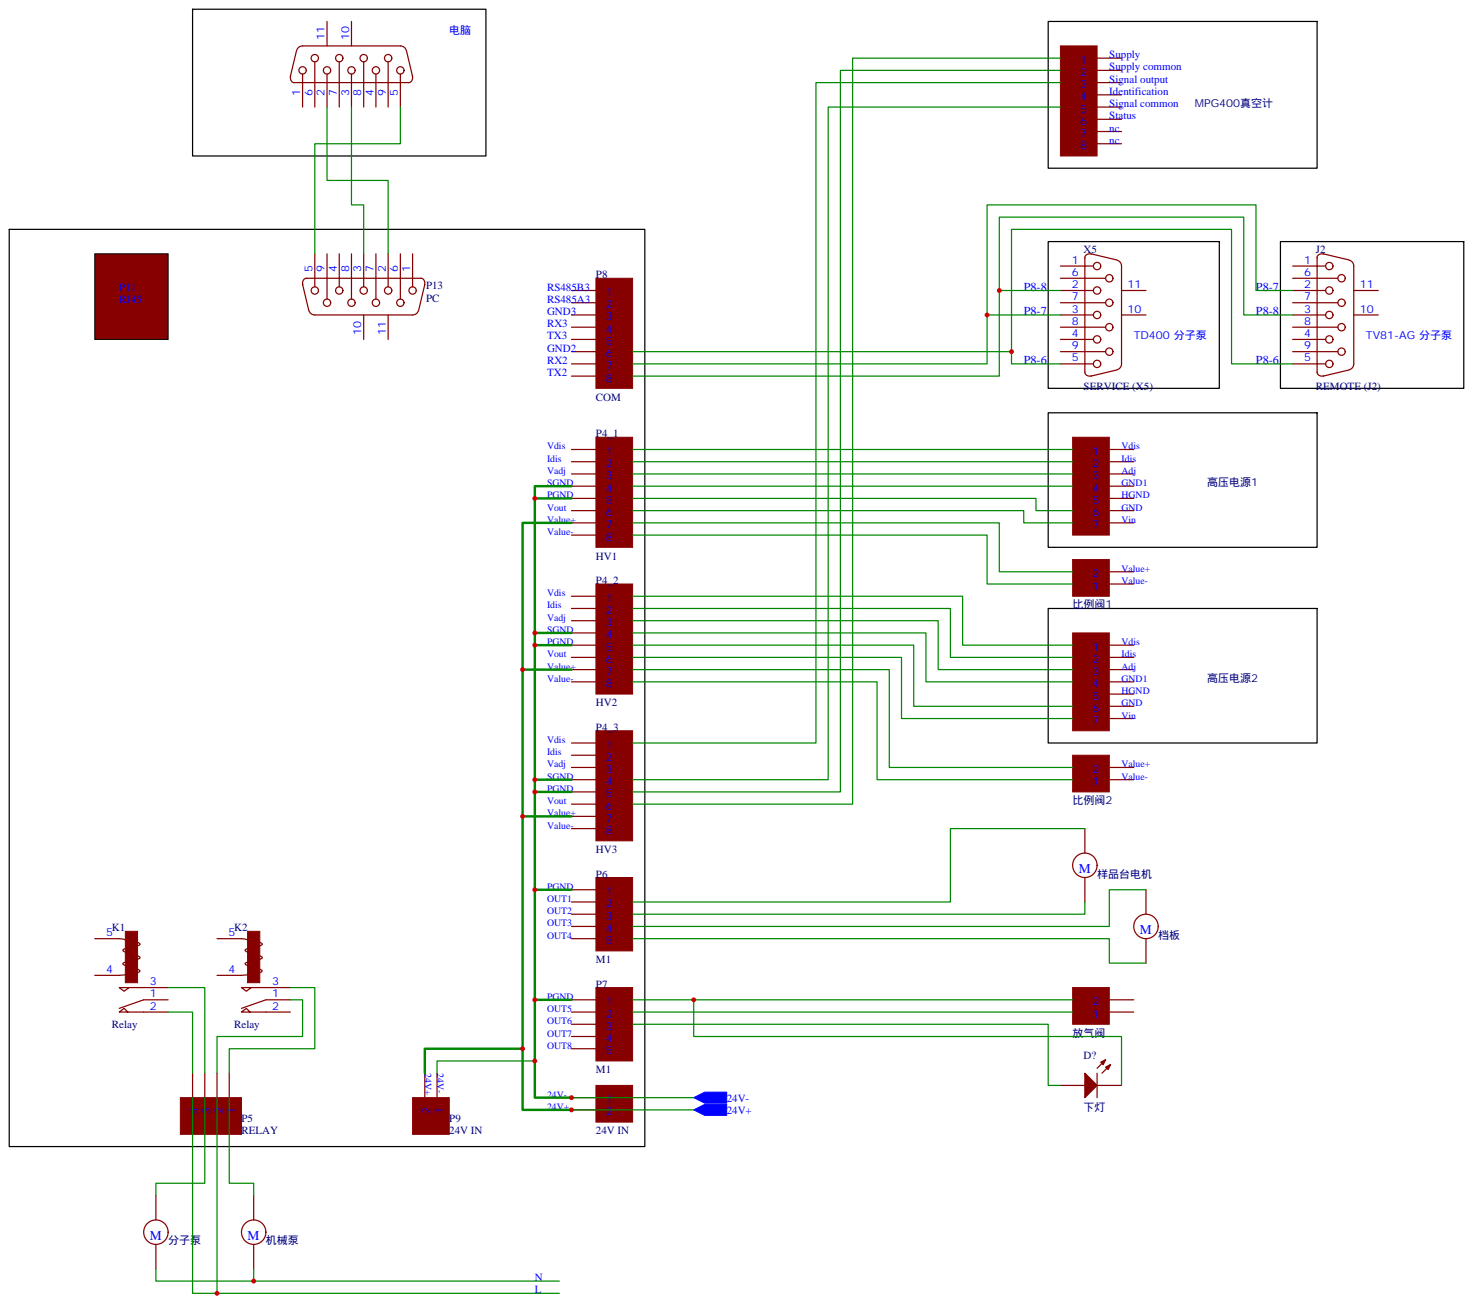
[picture p16: page 1]
