gitzzc/GLHW/AL1000/Ver1.10/AL1000装配资料/系统接线图.pdf

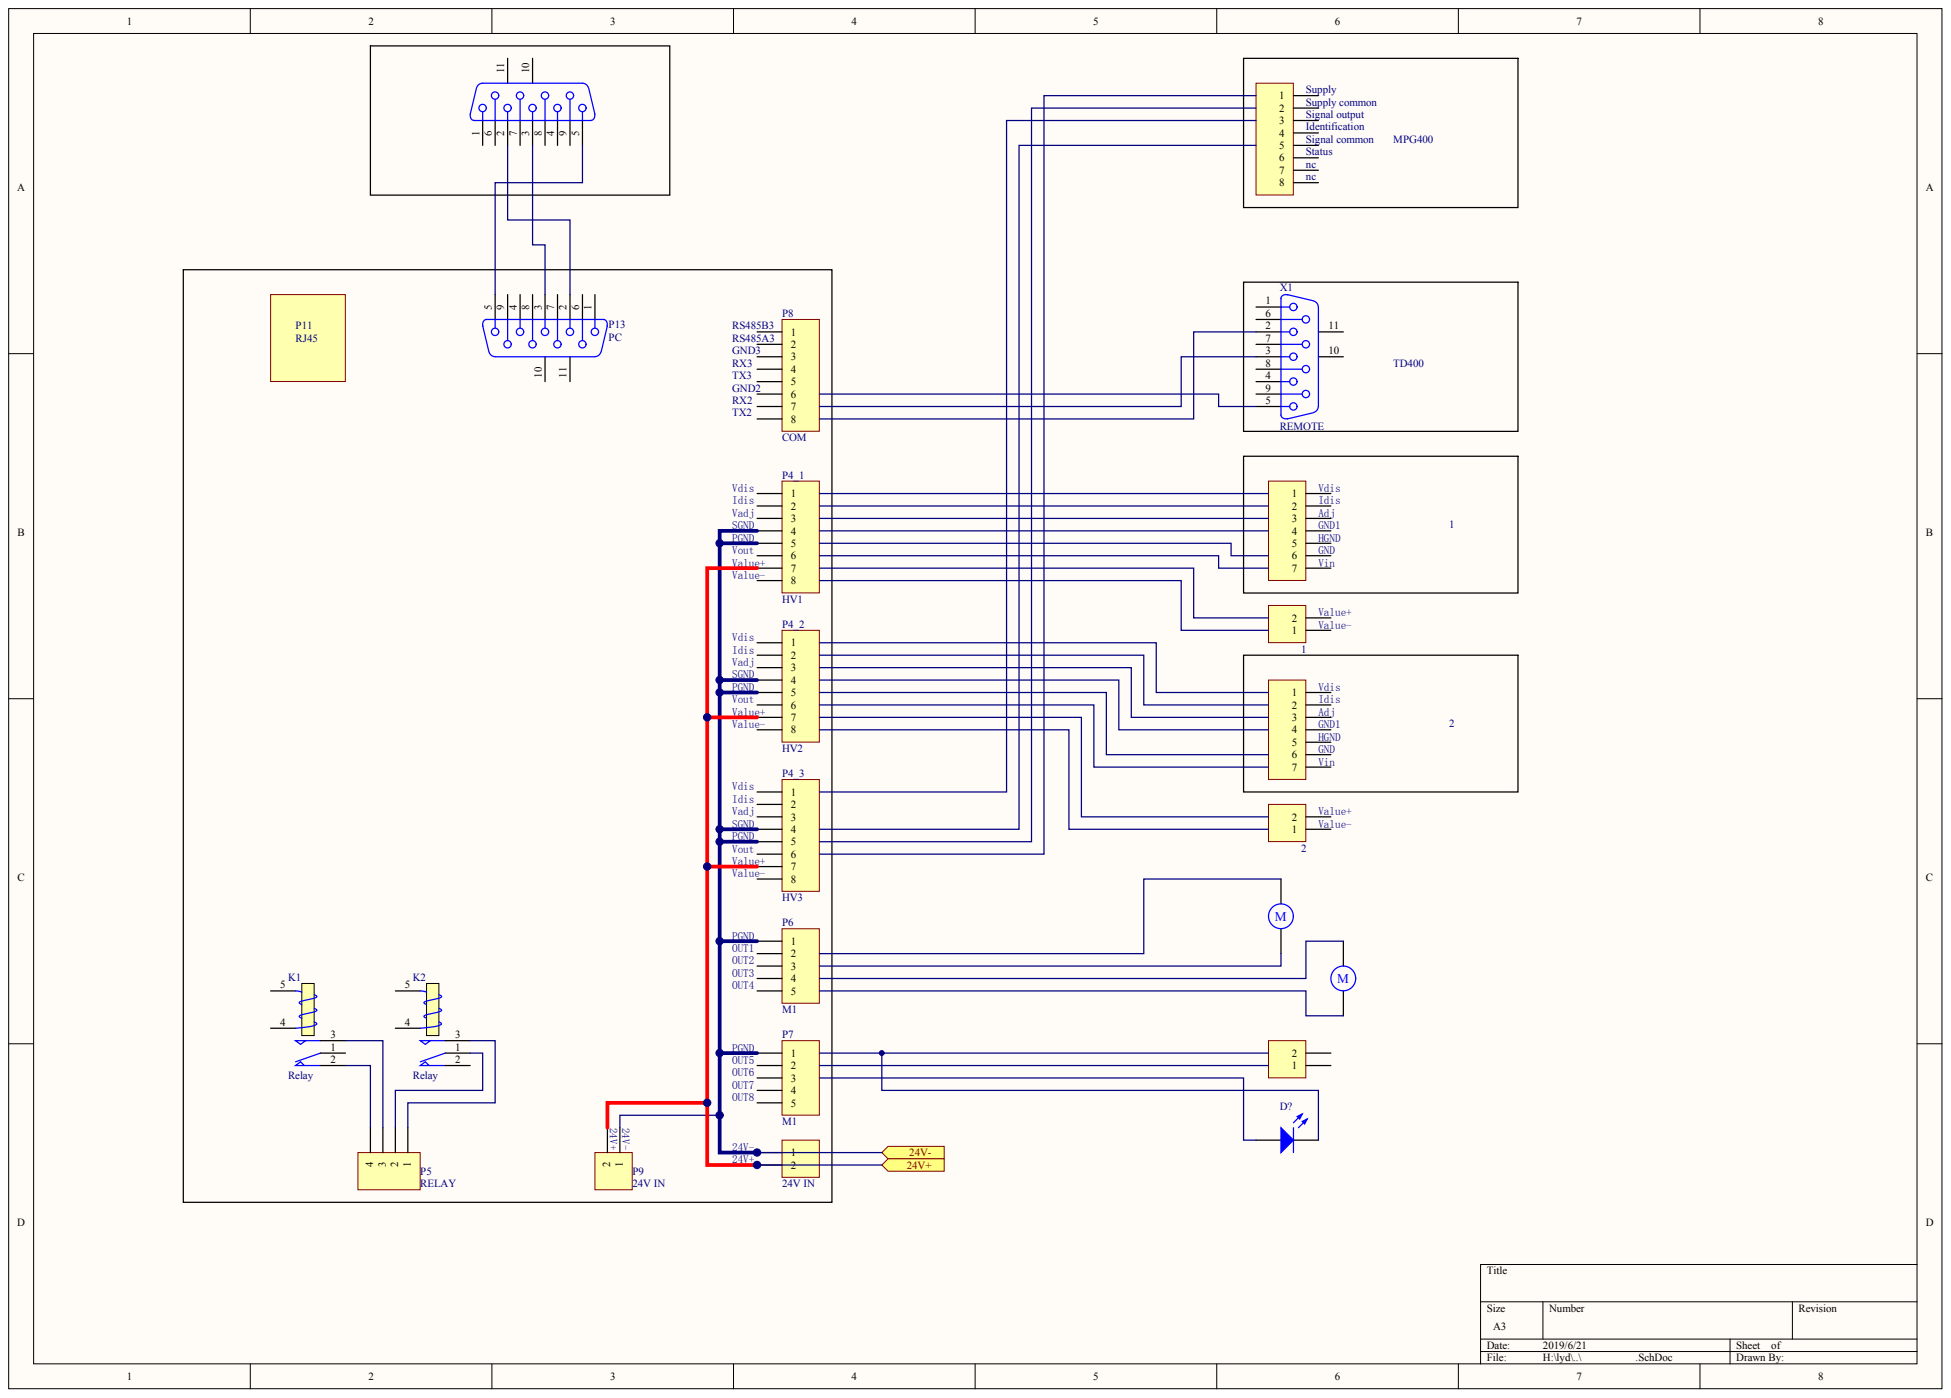
[picture p17: page 1]

PGND
Vout Value

Value Vdis Idis Vadj SGND | -

PGND | | | 1234567

Value PGND | -
