gitzzc/GLHW/AL1000/Ver1.10/POWER.PDF

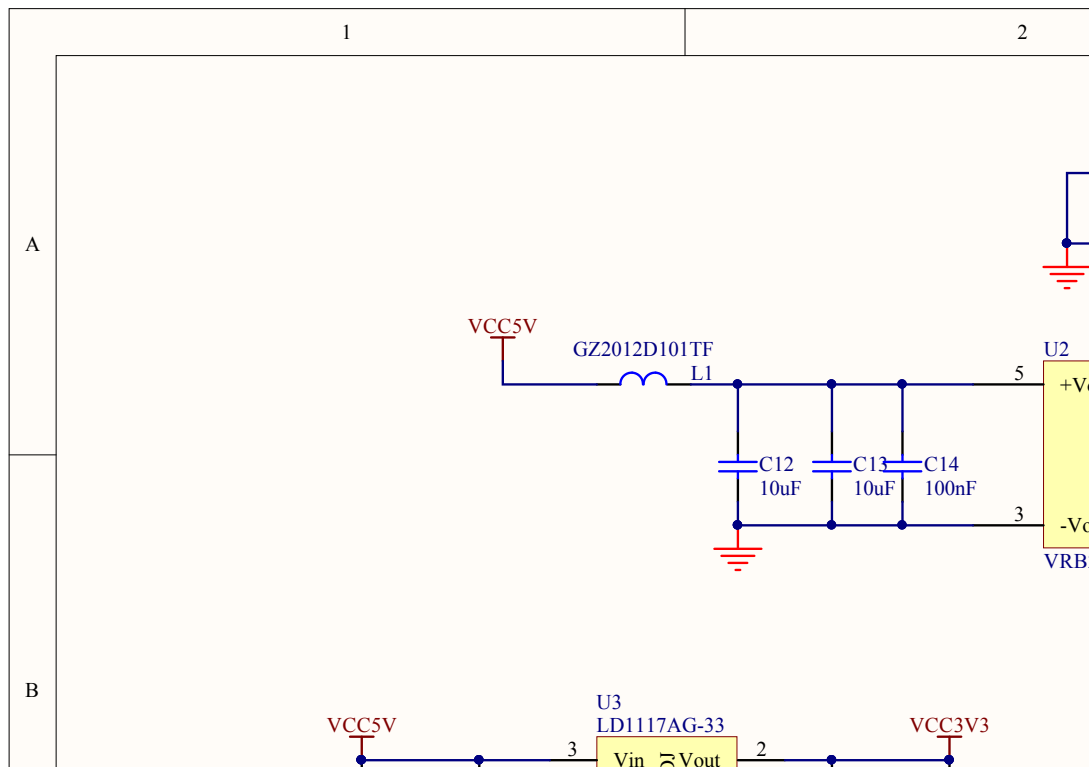
[picture p18: page 1]
