gitzzc/GLHW/AL1000/Ver1.10/系统接线图.PDF

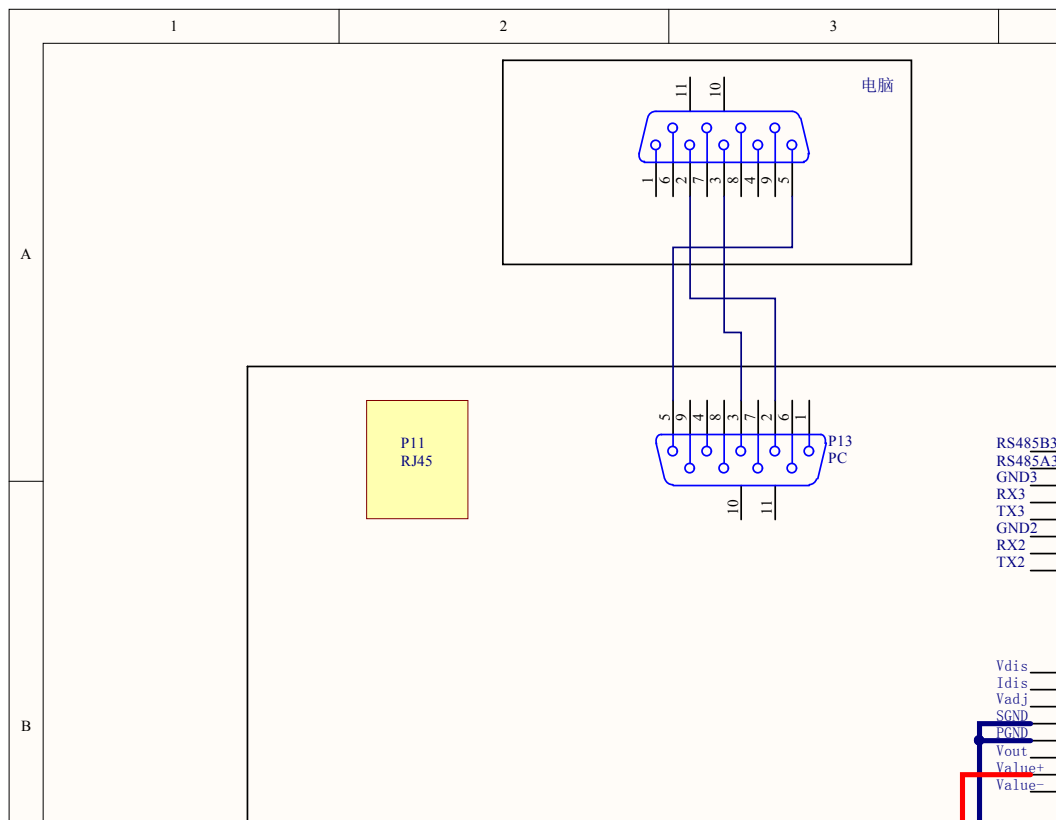
[picture p19: page 1]

PGND
Vout Value+

Value-
