gitzzc/GLHW/(list of files, drawings)

Other design files:
AL1000/Ver1.10/AL1000.PrjPcb
AL1000/Ver1.10/AL1000.SchDoc
AL1000/Ver1.10/EtherNet.SchDoc
AL1000/Ver1.10/HV.SchDoc
AL1000/Ver1.10/POWER.SchDoc
AL1000/Ver1.10/relay.SchDoc
AL1000/Ver1.10/stm32.SchDoc
AL1000/Ver1.10/uart.SchDoc
AL1000/Ver1.10/接线、装配/系统接线图.SchDoc
AL1000/Ver1.10/系统接线图.SchDoc
