gitzzc/GLHW/(commit log)

2018-03-25 change MMBT5551->MMBT5401
    [Valve.PcbDoc, Valve.SchDoc]
2019-03-31 20190331 Update to AL1000
    [AL1000.PrjPcb, AL1000.SchDoc, Bus.PcbDoc, Bus.PcbLib, Bus.PrjPcb, Bus.SchDoc, COMM.SchDoc, EtherNet.SchDoc]
2020-06-13 AL1000-V1.1 INIT
    [AL1000-1.xlsx, AL1000-V1.1.CSV, AL1000-V1.1.xls.xlsx, AL1000.DWG, AL1000.PrjPcb, AL1000.SchDoc, BOM_AL1000_20200329174914.csv, EtherNet.SchDoc]
